jerash/mawzer/README.md

# mawzer
Mawzer modular MIDI controller
designed by Jerash Labs in 2006, Raphaël Mouneyres and WaveIdea

In 2024 we make some documents available to the public mainly for repairability.

Source code is made available without support or warranty
