jerash/mawzer/BOM/BOM Mawzer V0-2I.XLS

Sheet: Info
Mawzer modular MIDI controller designed by Jerash Labs in 2006, Raphaël Mouneyres and WaveIdea
In 2024 we make some documents available to the public mainly for repairability.
 | This is the main hierarchical BOM
 | ASS_* are assembly BOMs
 | PLAT_* are board BOMs

Sheet: ASS VALISE 16
N° | Description | Désignation | Footprint | Quantité | Commentaires | Fabricant | Référence
1 | ENCLOSURE MATRICE16 + SERIGRAPHY |  |  | 1 |  | KAP
2 | PLAT_Mainboard |  |  | 1 |  | KAP
3 | ASS_FDP |  |  | 8 |  | KAP
4 | LIMANDE_FDP |  |  | 1 |  | KAP
5 | SNAP BUSHING PLASTIC |  |  | 32 |  | KAP | MAWZER_SNAP_BUSHING
6 | CAP ENCODEUR S470006BLACK |  |  | 1 | JOG ENCODER | Sifam | S470006BLACK
7 | CAP ENCODEUR CF470CAP/HOLE BLACK |  |  | 1 | JOG ENCODER | Sifam | CF470CAP/HOLE BLACK
8 | CAP ENCODEUR DA210006BLACK |  |  | 1 | NAV ENCODER | Sifam | DA210006BLACK
9 | CAP ENCODEUR C210BLACK |  |  | 1 | NAV ENCODER | Sifam | C210BLACK
10 | CAP POWERSWITCH |  |  | 1 |  | KAP | switch button black
11 | SCREW M3.5X9,5 TC CRUSIF |  |  | 4 | Enclosure fixing to flightcase | SONY
12 | M3 screw |  | 5mm | 10 |  | KAP | Vis M3 fixation pcb sur tole
13 | FLIGHT CASE 32 MAWZER |  |  | 1 |  | Cipex | RRMAWZER32
14 | ALIM CUI DTS090133SUD |  |  | 1 |  | CUI | DTS090133SUD
15 | MAWZER EXTRACTION TOOL |  |  | 2 |  | KAP | MAWZER_EXTRACTION_TOOL
16 | USER MANUAL |  |  | 1 |  | SONY
17 | CE conformity sheet |  |  | 1 |  | SONY
19 | PACKAGING MAWZER16 |  |  | 1 |  | SONY
20 | Standard USB cable, 1.8m, A to B type |  |  | 1 |  | KAP

Sheet: ASS VALISE 32
N° | Description | Designation | Footprint | Quantité | Commentaires | Fabricant | Référence
1 | ENCLOSURE MATRICE32 + SERIGRAPHY |  |  | 1 |  | KAP
2 | PLAT_Mainboard |  |  | 1 |  | KAP
3 | ASS_FDP |  |  | 16 |  | KAP
4 | LIMANDE_FDP |  |  | 1 |  | KAP
5 | BRIDGE_FDP |  |  | 8 |  | KAP
6 | SNAP BUSHING PLASTIC |  |  | 64 |  | KAP | MAWZER_SNAP_BUSHING
7 | CAP ENCODEUR S470006BLACK |  |  | 1 | JOG ENCODER | Sifam | S470006BLACK
8 | CAP ENCODEUR CF470CAP/HOLE BLACK |  |  | 1 | JOG ENCODER | Sifam | CF470CAP/HOLE BLACK
9 | CAP ENCODEUR DA210006BLACK |  |  | 1 | NAV ENCODER | Sifam | DA210006BLACK
10 | CAP ENCODEUR C210BLACK |  |  | 1 | NAV ENCODER | Sifam | C210BLACK
11 | CAP POWERSWITCH |  |  | 1 |  | KAP | switch button black
12 | SCREW M3.5X9,5 TC CRUSIF |  |  | 4 | Enclosure fixing to flightcase | SONY
13 | M3 screw |  | 5mm | 10 |  | KAP | Vis M3 fixation pcb sur tole
14 | FLIGHT CASE 32 MAWZER |  |  | 1 |  | Cipex | RRMAWZER32
15 | ALIM CUI DTS090133SUD |  |  | 1 |  | CUI | DTS090133SUD
16 | MAWZER EXTRACTION TOOL |  |  | 2 |  | KAP | MAWZER_EXTRACTION_TOOL
17 | USER MANUAL |  |  | 1 |  | SONY
18 | CE conformity sheet |  |  | 1 |  | SONY
19 | PACKAGING MAWZER32 |  |  | 1 |  | SONY
20 | Standard USB cable, 1.8m, A to B type |  |  | 1 |  | KAP

Sheet: BRIDGE_FDP
N° | Description | Designation | Footprint | Quantité | Commentaires | Fabricant | Référence
1 | Header 3 pins |  |  | 2 |  | Molex | 51004-0300
2 | Terminals for Header 3 pins |  |  | 3 |  | Molex | 70058-0022
3 | AWG24 Wire |  |  |  |  | Any

Sheet: LIMANDE_FDP
N° | Description | Designation | Footprint | Quantité | Commentaires | Fabricant | Référence
1 | Header 24 pins double row |  |  | 1 |  | Molex | 70450-0011
2 | Terminals for Header 24 |  |  | 24 |  | Molex | 70058-0022
3 | Header 3 pins |  |  | 8 |  | Molex | 51004-0300
4 | AWG24 Wire |  |  |  |  | Any

Sheet: ASS POTh
N° | Description | Designation | Footprint | Quantité | Commentaires | Fabricant | Référence
1 | Enclosure POTh |  |  | 1 |  | KAP
2 | PLAT_Module_Core |  |  | 1 |  | KAP
3 | PLAT_POT |  |  | 1 |  | KAP
4 | Plastic Module 1U |  |  | 1 |  | KAP
5 | Jacks 6.35mm male with connector |  |  | 2 |  | TOPUP
6 | M3 screw |  | 5mm | 3 |  | KAP | M3 screw
7 | M3 screw |  | 20mm | 2 |  | KAP | M3 screw
8 | spacer for pcb |  | 11mm | 2 |  | KAP | round plastic/metal unthreaded
9 | Caps 3/02/DRN110 006/26 BLACK/PALE BLUE 105 |  |  | 4 |  | Sifam | 3/02/DRN110 006/26 BLACK/PALE BLUE 105

Sheet: ASS POTv
N° | Description | Designation | Footprint | Quantité | Commentaires | Fabricant | Référence
1 | Enclosure POTv |  |  | 1 |  | KAP
2 | PLAT_Module_Core |  |  | 1 |  | KAP
3 | PLAT_POT |  |  | 1 |  | KAP
4 | Plastic Module 1U |  |  | 1 |  | KAP
5 | Jacks 6.35mm male with connector |  |  | 2 |  | TOPUP
6 | M3 screw |  | 5mm | 3 |  | KAP | M3 screw
7 | M3 screw |  | 20mm | 2 |  | KAP | M3 screw
8 | spacer for pcb |  | 11mm | 2 |  | KAP | round plastic/metal unthreaded
9 | Caps 3/02/DRN110 006/26 BLACK/PALE BLUE 105 |  |  | 4 |  | Sifam | 3/02/DRN110 006/26 BLACK/PALE BLUE 105

Sheet: ASS FAD
N° | Description | Designation | Footprint | Quantité | Commentaires | Fabricant | Référence
1 | Enclosure FAD |  |  | 1 |  | KAP
2 | PLAT_Module_Core |  |  | 1 |  | KAP
3 | PLAT_FAD |  |  | 1 |  | KAP
4 | Plastic Module 1U |  |  | 1 |  | KAP
5 | Jacks 6.35mm male with connector |  |  | 2 |  | TOPUP
6 | M3 screw |  | 5mm | 3 |  | KAP | M3 screw
7 | M3 screw |  | 20mm | 2 |  | KAP | M3 screw
8 | spacer for pcb |  | 10mm | 2 |  | KAP | round plastic/metal unthreaded
9 | Cap 3/02/LK110 04 SLIDER BLACK WHITE LINE |  |  | 1 |  | Sifam | 3/02/LK110 04 SLIDER BLACK WHITE LINE

Sheet: ASS BUT
N° | Description | Designation | Footprint | Quantité | Commentaires | Fabricant | Référence fabricant
1 | Enclosure BUT |  |  | 1 |  | KAP
2 | PLAT_Module_Core |  |  | 1 |  | KAP
3 | PLAT_BUT |  |  | 1 |  | KAP
4 | Plastic Module 1U |  |  | 1 |  | KAP
5 | Jacks 6.35mm male with connector |  |  | 2 |  | TOPUP
6 | M3 screw |  | 5mm | 3 |  | KAP | M3 screw
7 | M3 screw |  | 20mm | 2 |  | KAP | M3 screw
8 | spacer for pcb |  | 14mm | 2 |  | KAP | round plastic/metal unthreaded

Sheet: ASS ENC
N° | Description | Designation | Footprint | Quantité | Commentaires | Fabricant | Référence fabricant
1 | Enclosure ENC |  |  | 1 |  | KAP
2 | PLAT_Module_Core |  |  | 1 |  | KAP
3 | PLAT_ENC |  |  | 1 |  | KAP
4 | Plastic Module 1U |  |  | 1 |  | KAP
5 | Jacks 6.35mm male with connector |  |  | 2 |  | TOPUP
6 | M3 screw |  | 5mm | 3 |  | KAP | M3 screw
7 | M3 screw |  | 20mm | 2 |  | KAP | M3 screw
8 | spacer for pcb |  | 13mm | 2 |  | KAP | round plastic/metal unthreaded
9 | Caps DCK 150 006 BLACK |  |  | 4 |  | Sifam | DCK 150 006 BLACK
10 | CapsTop C150 BLACK |  |  | 4 |  | Sifam | C150 BLACK

Sheet: ASS XFD
N° | Description | Designation | Footprint | Quantité | Commentaires | Fabricant | Référence
1 | Enclosure XFD |  |  | 1 |  | KAP
2 | PLAT_Module_Core |  |  | 1 |  | KAP
3 | PLAT_XFD |  |  | 1 |  | KAP
4 | Plastic Module 1U |  |  | 1 |  | KAP
5 | Jacks 6.35mm male with connector |  |  | 2 |  | TOPUP
6 | M3 screw |  | 5mm | 3 |  | KAP | M3 screw
7 | M3 screw |  | 20mm | 2 |  | KAP | M3 screw
8 | spacer for pcb |  | 8mm | 2 |  | KAP | round plastic/metal unthreaded
9 | Crossfader Knob |  |  | 1 |  | TOPUP | KB091

Sheet: PLAT_Motherboard
 | Description | Designator | Footprint | Quantity | Option | Manufacturer | Ref Manufacturer | Digikey PartNb | Mouser Partnb
1 | 1-of-8 FET Multiplexer/Demultiplexer | U18, U19 | D016 | 2 |  | Texas | SN74CBT3251D | 296-6428-5-ND
2 | 2-1 Analog Mux-Demux 3.3V | U6, U8 | SSOP8_DCT | 2 |  | Texas | SN74LVC2G53DCTR | 296-13269-1-ND
3 | 2-Input AND Gate | U7 | 419A-01 | 1 |  | Texas | SN74AHC1G08DCK | 296-8743-1-ND
4 | 3mm round Led - Red - Right angle SMD | D1 | LXH305SRD | 1 |  | Lumex | LXH305SRD |  | 696-SSF-LXH305SRD
5 | 5 pins 180 deg DIN connector female | J9 | SDS50J_DIN5_NB | 1 |  | CUI Inc | SDS-50J (MIDI IN 0) | CP-2350-ND
6 | 5 pins 180 deg DIN connector female | J8 | SDS50J_DIN5_NB | 1 |  | CUI Inc | SDS-50J (MIDI OUT 1) | CP-2350-ND
7 | 5 pins 180 deg DIN connector female | J7 | SDS50J_DIN5_NB | 1 |  | CUI Inc | SDS-50J (MIDI TRHU) | CP-2350-ND
8 | 8 pins socket, 2.54mm | J11 | DIP8_DUMMY | 1 | Cut 2 x 4 pins | KAP | mill-max 310-93-108-41-001000 | 929400E-01-08-ND
9 | 20 pins header, male 2.54mm single row | J1 | 20PIN_SINGLE_ROW | 1 |  | KAP | Amp 2-103239-0 | 929400E-01-20-ND
10 | 64K/4K Flash micro controller Z8encore | U9 | F-QFP10x10-G64/N | 1 |  | Zilog | Z8F6422AR020SG | 269-4283-ND
11 | Adjustable 500mA regulator | U16, U17 | D-PAK | 2 |  | on semiconductor | LM317MDT | LM317MDTRKGOSCT-ND
12 | Capacitor standard voltage 10% tolerance | C48 | 805 | 1 | ceramic | Any | 10nF
13 | Capacitor 10% tolerance | C27 | 1206 | 1 | ceramic | Any | 10uF/6.3V
14 | Capacitor standard voltage 10% tolerance | C57 | 805 | 1 | ceramic | Any | 1nF
15 | Capacitor 10% tolerance | C10 | 0805_NM | 1 | Not Mounted | Any | 1uF/6,3V
16 | Capacitor 10% tolerance | C54 | 805 | 1 | ceramic | Any | 2.2uF/6,3V
17 | Capacitor standard voltage 10% tolerance | C8, C39 | 0805_NM | 2 | Not Mounted | Any | 100nF
18 | Capacitor 10% tolerance | C35, C38 | 6032_ALU | 2 | electrolytic | Any | 10uF-25V
19 | Capacitor standard voltage 10% tolerance | C44, C45 | 805 | 2 | ceramic | Any | 12pf
20 | Capacitor standard voltage 10% tolerance | C25, C26 | 805 | 2 | ceramic | Any | 18pF
21 | Capacitor 10% tolerance | C40, C61 | 805 | 2 | ceramic | Any | 1uF/6,3V
22 | Capacitor 10% tolerance | C4, C23, C41 | CAP_ALU_4x5 | 3 | electrolytic | Any | 10uF/16V
23 | Capacitor 10% tolerance | C32, C34, C37 | 6032_ALU | 3 | electrolytic | Any | 47uF-25V
24 | Capacitor standard voltage 10% tolerance | C1, C2, C3, C5, C6, C7, C9, C11, C12, C13, C14, C15, C16, C17, C18, C19, C20, C21, C22, C24, C28, C29, C30, C31, C33, C36, C42, C43, C46, C47, C49, C50, C51, C52, C53, C58, C60 | 805 | 37 | ceramic | Any | 100nF
25 | connector header 2.5mm, 3x2 pins vertical | JP1 | HEADER_3X2 | 1 | NOT MOUNTED | KAP | HEADER 3X2 | 929710E-10-03-ND
26 | Crystal CMS | X1 | HC49/SUB | 1 |  | Citizen | HCM49-20.000MABJT (20MHz) | 300-6142-1-ND
27 | Crystal CMS | X2 | HC49/SUB | 1 |  | Citizen | HCM4924.000MABJTR |  | 695-HCM49-24
28 | Default Diode | D3, D5, D6, D7 | DSO-C2/X3.3 | 4 | DO-214AC | Any | 1N4001 | 1N4001-ND
29 | Diode bridge 1A - 50V, CMS | D4 | DF-S | 1 |  | Any | DF005S | DF005SDI-ND
30 | Diode small signal | D2 | 0805D | 1 | SOD-123 | Any | Diodes Inc 1N4148W-7 | 1N4148WDICT-ND | Boitier SOD-123
31 | Diode small signal | D8 | DSO-G2/Z5 | 1 | SOD-123 | Any | Diodes Inc 1N4148W-7 | 1N4148WDICT-ND | Boitier SOD-123
32 | DPDT switch, right angle pcb mounted | S21 | F2UEE | 1 |  | ITT Canon | F2UEE | 401-1223-ND
33 | Dual pins vertical, 2.54mm pitch | CON1 | 2_PINS_HEADER | 1 |  | KAP | STC02SYAN | S9000-ND
34 | Dual tri-state buffer | U5 | SSOP8_DCT | 1 |  | Texas | SN74LVC2G125DCTR | 296-12164-1-ND
35 | EZ-USB FX2 USB High-speed USB Peripheral Controller 16K | U4 | R-QFP14x20-G100/N | 1 |  | Cypress | CY7C68013A-100AXC | 428-1667-ND
36 | Ferrite bead - 1.5A | L1 | INDC4516-1806 | 1 |  | Murata | BLM41PG102SN1L | 490-1061-1-ND
37 | Hardware terminal with screw, right angle | J2, J4, J5 | KEYSTONE_EQUERRE | 3 |  | Keystone | 7690-3 | 7690K-ND
38 | Header, 12-Pin, Dual row, Right Angle | P2 | HDR2X12H | 1 |  | KAP | Header 12X2H
39 | Card Edgeboard Connectors .100 DIP 20POS | P5 | EBC10DCWN | 1 |  | Sullins | Sullins EBC10DCWN | S3299-ND
40 | Inductor choke type | L5 | 1210 | 1 |  | Murata | LQH3C100K04 | Obsolete | 81-LQH32CN100K01L
41 | Inductor high speed, low current | L2, L3 | 805 | 2 |  | Murata | BLM21B221SB
42 | Inductor high speed, USB power line | L4 | 805 | 1 |  | Murata | BLM21P221SG | 490-1054-2-ND | BLM21PG221SN1D
43 | LCD 128x64, STN blue negative, transmissive, white led bl | LCD1 | LCD_128X64_DUMMY | 1 |  | Microtips | MTG-S12864KMNHSGW-01 |  | voir Waveidea
44 | Optocoupler 8 pins DIP | U13 | DIP8 | 1 |  | Fairchild | 6N138 | 6N138QT-ND
45 | Piher Trimmer Potentiometers 10Kohms 10mm Rnd Top adj | P1 | PTV_POT | 1 |  | Piher | PT10V-10K |  | 531-PT10V-10K
46 | Power supply jack 2.1mm, right angle | J6 | JACK_ALIM_CUI | 1 |  | CUI Inc | PJ-102A | CP-102A-ND
47 | Power switch cap, round 8.8mm, gray | S22 | PWR_SW_CAP | 1 |  | ITT canon | FG/GRY | 401-1217-ND
48 | pushbutton + cap + led | SW4 | 3FTL6 | 1 |  | Mec | 3FTL6201Q091
49 | pushbutton + cap + led | SW1 | 3FTL6 | 1 |  | Mec | 3FTL6801R091
50 | pushbutton + cap + led | SW2, SW3, SW5, SW6, SW7, SW8, SW9, SW10 | 3FTL6 | 8 |  | Mec | 3FTL61P09
51 | Resetable fuse 1A - SMD | F1 | MF-SM050-2-99 | 1 |  | Bourns | MF-SM050-2-99 |  | 652-MFSM050-2-LF
52 | Rotary encoder, 25mm, no switch, no detent, D shaft | E2 | EC110102_EC16 | 1 |  | soundwell | EC110104B2B-HA1-022 (15P0-KA250A100-N)
53 | Rotary encoder, 16mm, with switch and detent, D shaft | E1 | EC110102_EC16 | 1 |  | soundwell | EC110101B2B-HA1-013 (15P6-FA200A100-N)
54 | Serial I2C EEPROM 16k x 8 DIP8 | U11 | DIP8 | 1 |  | Catalyst | CAT24AC128P
55 | Serial I2C EEPROM 32k x 8 DIP/SOIC8 | U1, U2, U3 | DIP8_SOIC8 | 3 |  | Atmel | AT24C256BN-10SU | AT24C256BN-10SU-1.8-ND
56 | shorting jumper 2.54 mm | J10 | JUMPER_DUMMY | 1 | open to disconect EZ-USB EEPROM | KAP
57 | Single buffer with 3 state output | U10 | SO-G5/P.95 | 1 | Not mounted | Texas | SN74AHCT1G125 | 296-4708-1-ND | SN74AHCT1G125DBVR (SOT23-5)
58 | Single buffer with 3 state output | U14, U15 | SO-G5/P.95 | 2 |  | Texas | SN74AHCT1G125 | 296-4708-1-ND | SN74AHCT1G125DBVR (SOT23-5)
59 | Standard CMS resistor 5% tolerance | R68 | 805 | 1 |  | Any | 1.2k
60 | Standard CMS resistor 5% tolerance | R91 | 805 | 1 |  | Any | 100R
61 | Standard CMS resistor 5% tolerance | R37 | 0805_NM | 1 | Not mounted | Any | 1M
62 | Standard CMS resistor 5% tolerance | R66 | 805 | 1 |  | Any | 470
63 | Standard CMS resistor 5% tolerance | R69 | 805 | 1 |  | Any | 5.6K
64 | Standard CMS resistor 5% tolerance | R77 | 805 | 1 |  | Any | 540R
65 | Standard CMS resistor 5% tolerance | R13, R19, R21, R36, R44, R50, R52, R55, R56, R57, R62, R64, R65 | 805 | 13 |  | Any | 0R
66 | Standard CMS resistor 5% tolerance | R54, R90 | 805 | 2 |  | Any | 100K
67 | Standard CMS resistor 5% tolerance | R16, R75 | 805 | 2 |  | Any | 1K
68 | Standard CMS resistor 5% tolerance | R4, R42 | 0805_NM | 2 | Not mounted | Any | 1K
69 | Standard CMS resistor 5% tolerance | R1, R2, R88, R89 | 805 | 4 |  | Any | 2.2k
70 | Standard CMS resistor 5% tolerance | R10, R12, R74, R76 | 805 | 4 |  | Any | 330R
71 | Standard CMS resistor 5% tolerance | R3, R5, R6, R7, R8, R9, R11, R14, R15, R17, R20, R23, R24, R25, R26, R27, R28, R29, R30, R31, R32, R33, R34, R35, R38, R39, R40, R43, R45, R63, R78, R79, R80, R81, R82, R83, R84, R85, R87, R92, R93, R94 | 805 | 42 |  | Any | 10K
72 | Standard CMS resistor 5% tolerance | R18, R22, R41, R47, R49, R51 | 0805_NM | 6 | Not mounted | Any | 0R
73 | Standard CMS resistor 5% tolerance | R53, R67, R70, R71, R72, R73 | 805 | 6 |  | Any | 220
74 | Standard CMS resistor 5% tolerance | R46, R48, R58, R59, R60, R61, R86, R95 | 0805_NM | 8 | Not mounted | Any | 10K
75 | USB Connector type B pcb mounted, 4 pins | J3 | USBCON | 1 |  | Kobicon | 154-2442 |  | 154-2442-E
76 | USB transient suppressor | U12 | DBV6 | 1 |  | Texas Inst | SN65220DBVT | 296-2341-2-ND
77 | PCB_Mainboard |  |  | 1 |  | KAP | PCB_Mainboard

Sheet: PLAT_CommonModule
 | Description | Designator | Footprint | Quantity | Option | Manufacturer | Ref | Digikey PartNb | Mouser PartNb
1 | Capacitor | C1000, C1004, C1006, C1007, C1009, C1010, C1012, C1013 | 805 | 8 | ceramic | Any | 100nF |  | 80-C0805C104K5R
2 | Capacitor | C1001, C1002 | 805 | 2 | ceramic | Any | 18pF |  | 80-C0805C180K5G
3 | Capacitor | C1003 | TC3528-1411 | 1 | electrolytic | Kemet | 47uF/10V | 493-2094-1-ND | 647-UWX1A470MCL1
4 | Capacitor | C1005, C1011 | 805 | 2 | ceramic | Any | 1uF |  | 581-0805ZC105K
5 | Capacitor | C1008 | CAP_ALU_4x5 | 1 | electrolytic | Kemet | 10uF/16V | 493-2099-6-ND | 647-UWX1C100MCL2
6 | connector header 2.5mm, 3x2 pins vertical | JP1000 | HEADER_3X2 | 1 | 2.54mm | KAP | HEADER 3X2 |  | 538-10-89-7061
7 | Inductor 0,1µH | L1000, L1001, L1002 | 805 | 3 |  | Any | CK2125R10M | 587-1685-1-ND
8 | Header, 3-Pin | P1000, P1001 | 530150310 | 2 | 2.54mm | KAP | molex 530150310 |  | 538-53015-0310
9 | Header, 20-Pin | P1002 | HDR1X20 | 1 | 2.54mm | KAP | TSW-120-17-G-S | 929400E-01-20-ND
10 | Standard CMS resistor | R2, R1016 | 805 | 2 | 5 % | Any | 2.2k |  | 71-CRCW0805J-2.2K
11 | Standard CMS resistor | R1000, R1002, R1012 | 805 | 3 | 5 % | Any | 10K |  | 71-CRCW0805J-10K-E3
12 | Standard CMS resistor | R1001 | 805 | 1 | 5 % | Any | 220R |  | 71-CRCW0805J-220
13 | Standard CMS resistor | R1003, R1005 | 0805_NM | 2 | Not mounted | Any | 10K | * | *
14 | Standard CMS resistor | R1004, R1008, R1010, R1014, R1017 | 805 | 5 | 5 % | Any | 0R |  | 71-CRCW0805-0-E3
15 | Standard CMS resistor | R1006 | 0805_NM | 1 | Not mounted | Any | 100K | * | *
16 | Standard CMS resistor | R1007, R1009, R1013 | 0805_NM | 3 | Not mounted | Any | 0R | * | *
17 | Standard CMS resistor | R1011 | 805 | 1 | 5 % | Any | 1K |  | 71-CRCW0805J-1K-E3
18 | Standard CMS resistor | R1015 | 0805_NM | 1 | Not mounted | Any | 45K | * | *
19 | DIP Switch, 6 Position, SPST | S1000 | BPA06SB | 1 |  | ITT | BPA06SB | CKN6145-ND | 611-BPA06SB
20 | Single buffer with 3 state output | U1000 | SO-G5/P.95 | 1 | PACKAGE ? | Texas | SN74AHCT1G125 | 296-4708-1-ND
21 | 200mA LDO - 5pins - 3.3V fixed output | U1001 | SO-G5/P.95 | 1 | PACKAGE ? | Texas | TPS79333 | 296-12961-1-ND
22 | Analog mux | U1002 | SOIC16D | 1 |  | Philips | CD74HC4051M | 296-14530-1-ND | 595-CD74HC4051M96
23 | 4K/1K Flash micro controller Z8encore - SOIC28 | U1003 | SOIC28 | 1 |  | Zilog | Z8F0422SJ020SG | 269-4143-ND | 692-Z8F0422SJ020SG
24 | Serial I2C EEPROM 2k x 8 SOIC8 | U1004 | SO-G8 | 1 |  | Atmel | AT24C16A-10SU-2.7 | AT24C16AN-10SU2.7-ND
25 | Crystal CMS | X1000 | HC49/SUB | 1 | NO ROHS NOSTOCK | Citizen | HCM49-20.000MABJT (20MHz) | 300-6142-2-ND | 695-HCM49-20
26 | M3 screw | - | - | 2 | - | KAP | Vis M3 pour fixation pcb sur spacers | * | *
27 | PCB CommonModule | - | - | 1 | - | KAP | PCB_COMMONMODULE | * | *

Sheet: PLAT_FDP
N° | Description | Designation | Footprint | Quantité | Commentaires | Fabricant | Référence
1 | PCB FDP |  |  | 1 |  | KAP
2 | Jack Socket, 6 pins right angle | J1,J2,J3,J4 | NMJ6HCD2 | 4 |  | Neutrik | NMJ6HCD2
3 | Header 3 pins right angle | P1, P2 | 530150310 | 1 |  | Molex | 530150310

Sheet: PLAT_POT
 | Description | Designator | Footprint | Quantity | Option | Manufacturer | Ref Manufacurer
1 | PCB POT |  |  | 1 |  | KAP
2 | Rotary potentiometer 11mm type vertical | P1, P2, P3, P4 | RA1150NOE0D-HA1 | 4 |  | Soundwell | RA1150NOE0D-HA1-064(B103-Q0--FB175B120-N)
3 | Header, 20-Pin, 2.54mm pitch | P1002 | HDR1X20 | 1 |  | Any

Sheet: PLAT_FAD
 | Description | Designator | Footprint | Quantity | Option | Manufacturer | Ref Manufacturer
1 | PCB FAD |  |  | 1 |  | KAP
2 | fader potentiometer 100mm type vertical | P1 | SKA191NOA0A-HA1 | 1 |  | Soundwell | SKA191NOA0A-HA1-B103-Q0-M13A100
3 | Header, 20-Pin, 2.54mm pitch | P1002 | HDR1X20 | 1 |  | Any

Sheet: PLAT_BUT
 | Description | Designator | Footprint | Quantity | Option | Manufacturer | Ref Manufacturer
1 | PCB BUT |  |  | 1 |  | KAP
2 | Boutons poussoir | SW1, SW2, SW3, SW4 | TL1240 | 4 |  | E-switch | TL1240RQ/2J-BLK
3 | Standard CMS resistor 10K | R1, R3, R5, R7 | 0805 | 4 |  | Any | Standard CMS resistor 10K
4 | Standard CMS resistor 330R | R2, R4, R6, R8 | 0805 | 4 |  | Any | Standard CMS resistor 330R
5 | Header, 20-Pin, 2.54mm pitch | P1002 | HDR1X20 | 1 |  | Any

Sheet: PLAT_ENC
 | Description | Designator | Footprint | Quantity | Option | Manufacturer | Ref Manufacturer
1 | PCB_ENC |  |  | 1 |  | KAP
2 | Encoders 15pulse/rotation w/detent | E1, E2, E3, E4 |  | 4 |  | Soundwell | EC110104B2B-HA1-020(15P6-FA200A100-N)
3 | Standard CMS capacitor 100nF | C1, C2, C3, C4, C5, C6, C7,C8, C9 | 0805 | 9 |  | Any | Standard CMS capacitor 100nF
4 | Standard CMS resistor 10K | R1, R2, R3, R4, R5, R6, R7,R8, R9, R10, R11, R12, R13,R14, R15, R16 | 0805 | 16 |  | Any | Standard CMS resistor 10K
5 | Header, 20-Pin, 2.54mm pitch | P1002 | HDR1X20 | 1 |  | Any
6 | Dual tri-state buffer | U5 | SSOP8_DCT | 1 |  | Texas Instruments | SN74LVC2G125DCTR

Sheet: PLAT_XFD
 | Description | Designator | Footprint | Quantity | Option | Manufacturer | Ref Manufacturer
1 | PCB_XFD |  |  | 1 |  | KAP
2 | slider potentiometer 60mm type vertical | P1 | SC6005NOA0X-HA1 | 1 |  | Soundwell | SC6005NOA0X-HA1-1B103-Q0-M13A150
3 | Buttons | SW1, SW2 |  | 2 |  | MEC | 3FTL680
4 | Buttons Caps |  |  | 2 |  | MEC | 1Q091
5 | Standard CMS resistor 10K | R1, R2 | 0805 | 2 |  | Any | Standard CMS resistor 10K
6 | Standard CMS resistor 330R | R3, R4 | 0805 | 2 |  | Any | Standard CMS resistor 330R
7 | Header, 20-Pin, 2.54mm pitch | P1002 | HDR1X20 | 1 |  | Any
