jerash/mawzer/(list of files, cad)

Other CAD files:
src/Motherboard/EzUsb_FX1_Fw_v10/main.OBJ
src/Motherboard/EzUsb_FX1_Fw_v10/dscr_bs3x.OBJ
src/Motherboard/EzUsb_FX1_Fw_v10/identity_inc.obj
src/Motherboard/EzUsb_FX1_Fw_v10/usb.OBJ
src/Motherboard/EzUsb_FX1_Fw_v10/STARTUP.OBJ
src/Motherboard/EzUsb_FX1_Fw_v10/serial.OBJ
src/Motherboard/EzUsb_FX1_Fw_v10/hardware.OBJ
src/Motherboard/EzUsb_FX1_Fw_v10/fw.OBJ
src/Motherboard/EzUsb_FX1_Fw_v10/periph.OBJ
src/Motherboard/EzUsb_FX1_Fw_v10/bootloader.OBJ
src/Motherboard/EzUsb_FX1_Fw_v10/midi_dscr.OBJ
src/Motherboard/EzUsb_FX1_Fw_v10/USBJmpTb.OBJ
src/Motherboard/EzUsb_FX1_Fw_v10/itr.OBJ
src/Motherboard/EzUsb_FX1_Fw_v10/dscr_mawzer.OBJ
src/Motherboard/EzUsb_FX1_Fw_v10/dscr.OBJ
src/Motherboard/EzUsb_FX1_Fw_v10/identity.OBJ
