jerash/mawzer/schematics/BUT_MODULE_V10.pdf

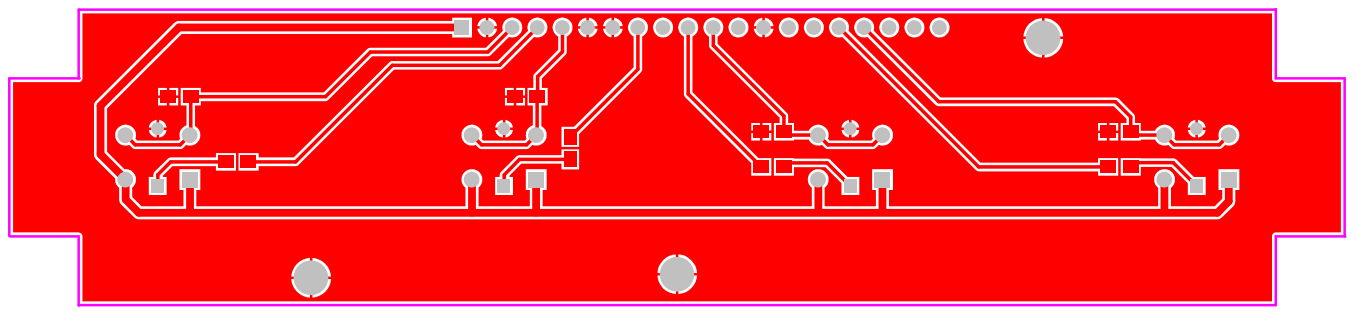
[picture p1: page 1]

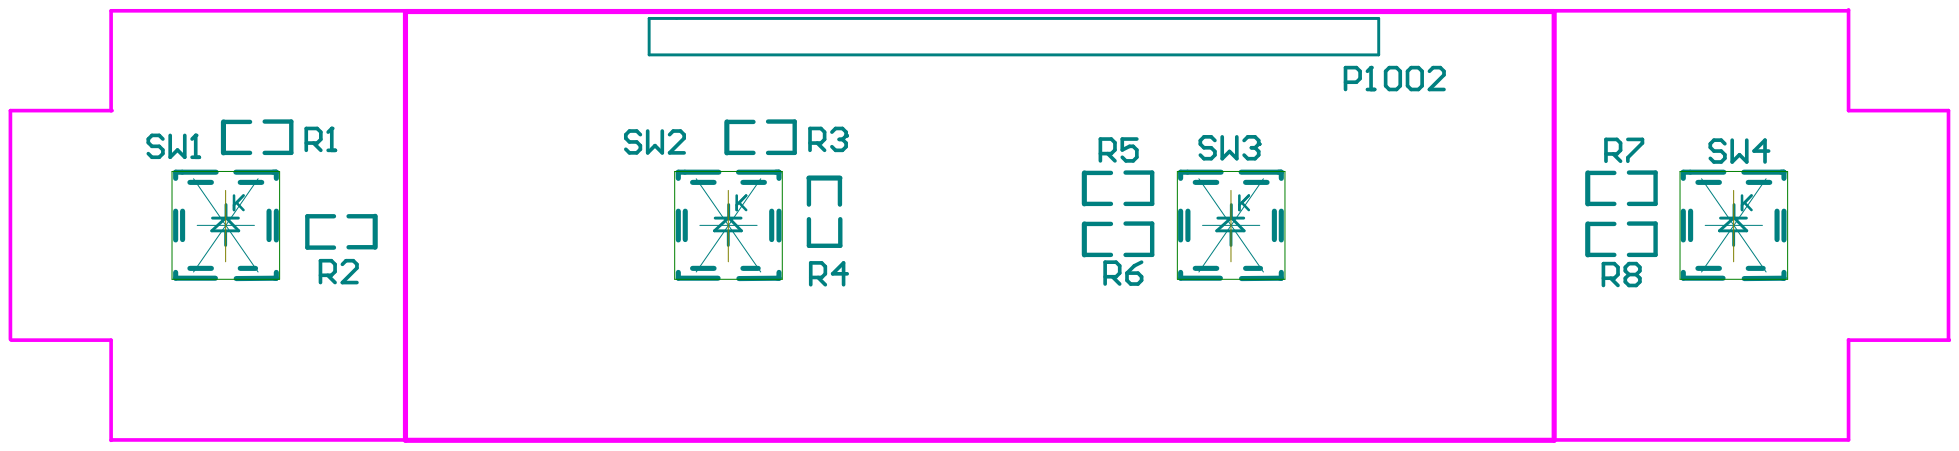
[picture p2: page 2]

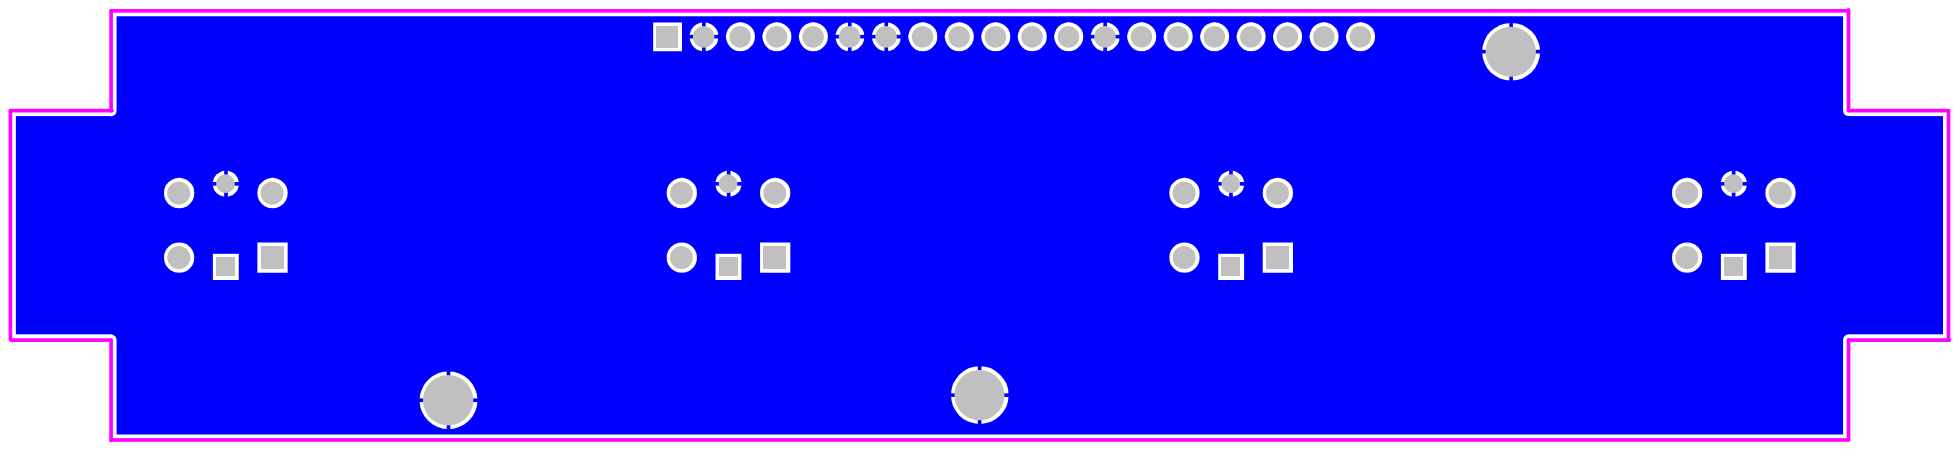
[picture p3: page 3]

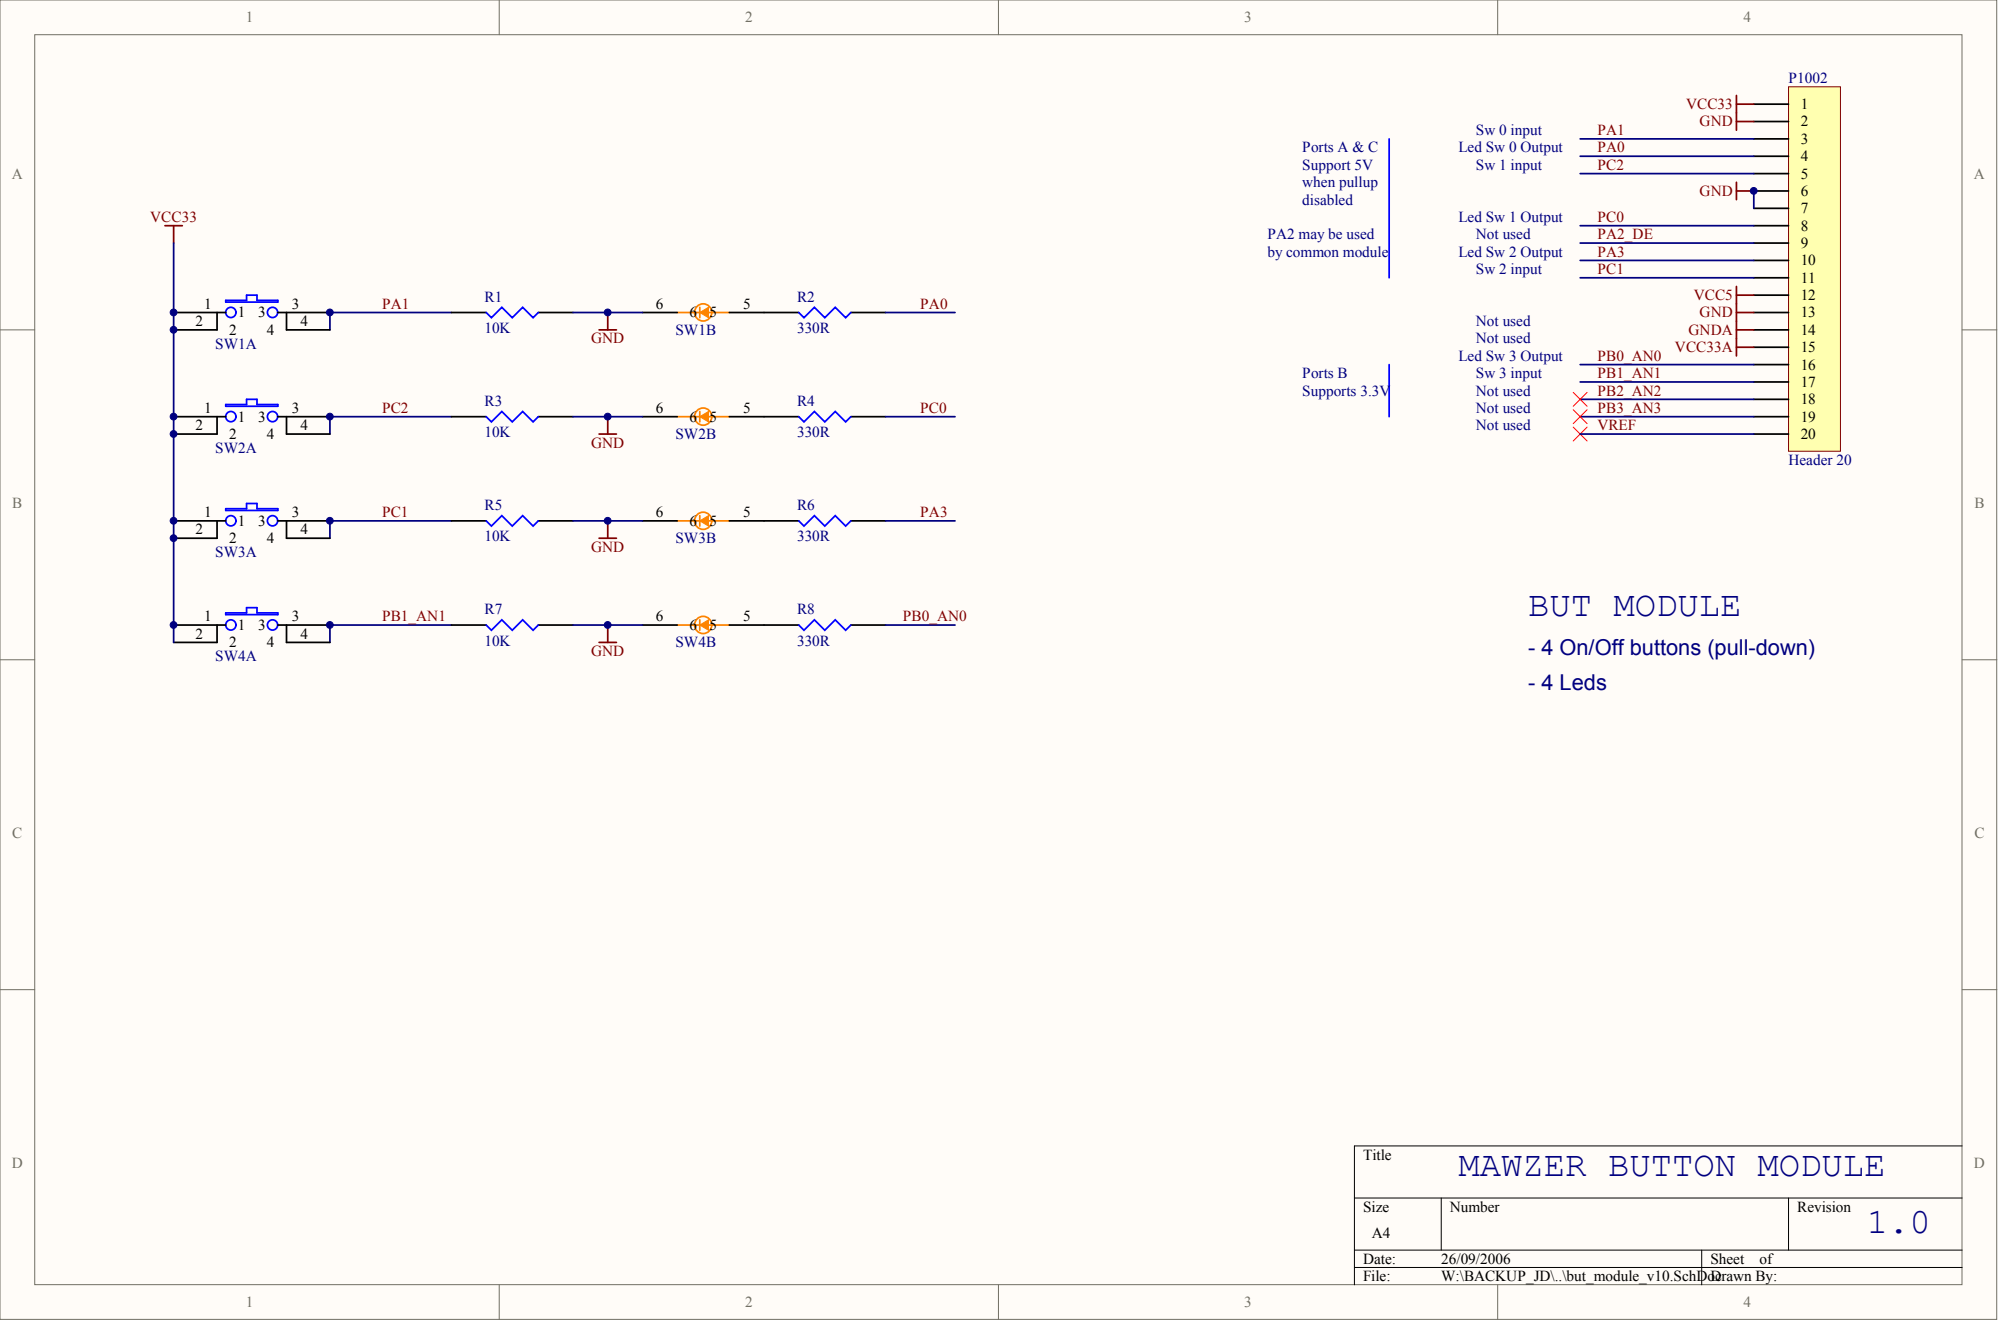
[picture p4: page 4]

Led Sw 0 Output Led Sw 1 Output Led Sw 2 Output Led Sw 3 Output
Sw 1 input

- 4 On/Off buttons (pull-down)
- 4 Leds
