jerash/mawzer/schematics/common_module_v10.pdf

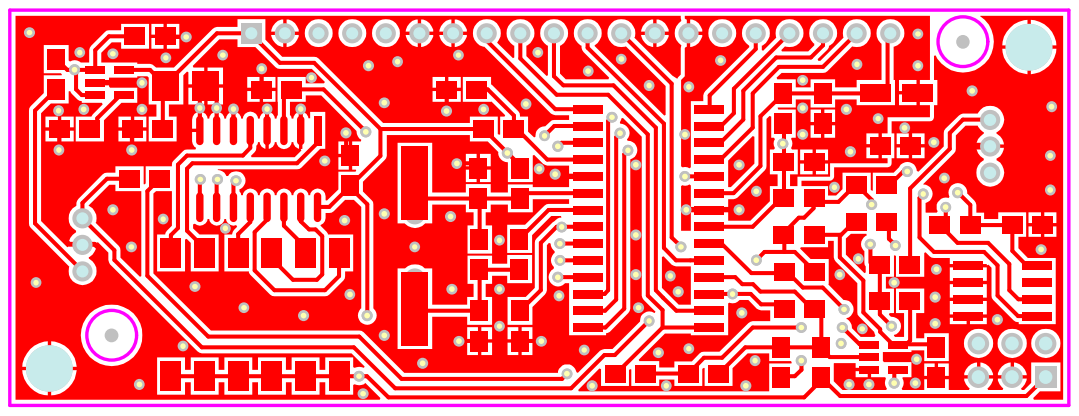
[picture p5: page 1]

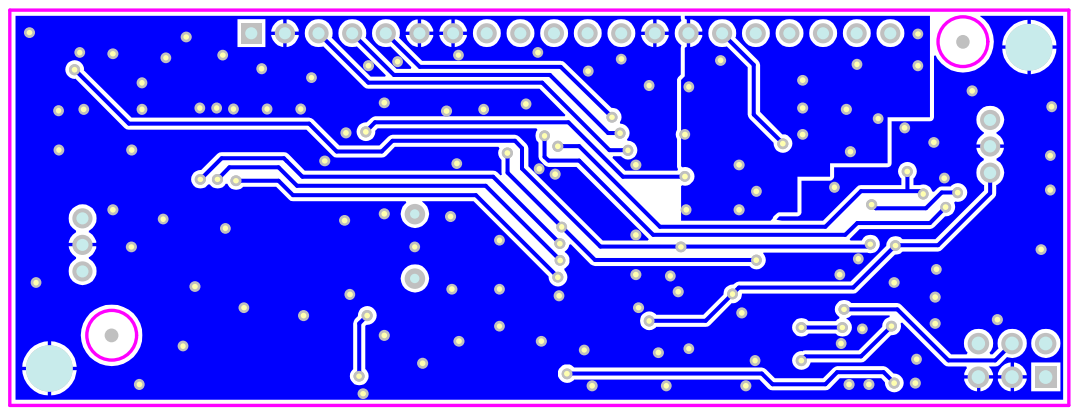
[picture p6: page 2]

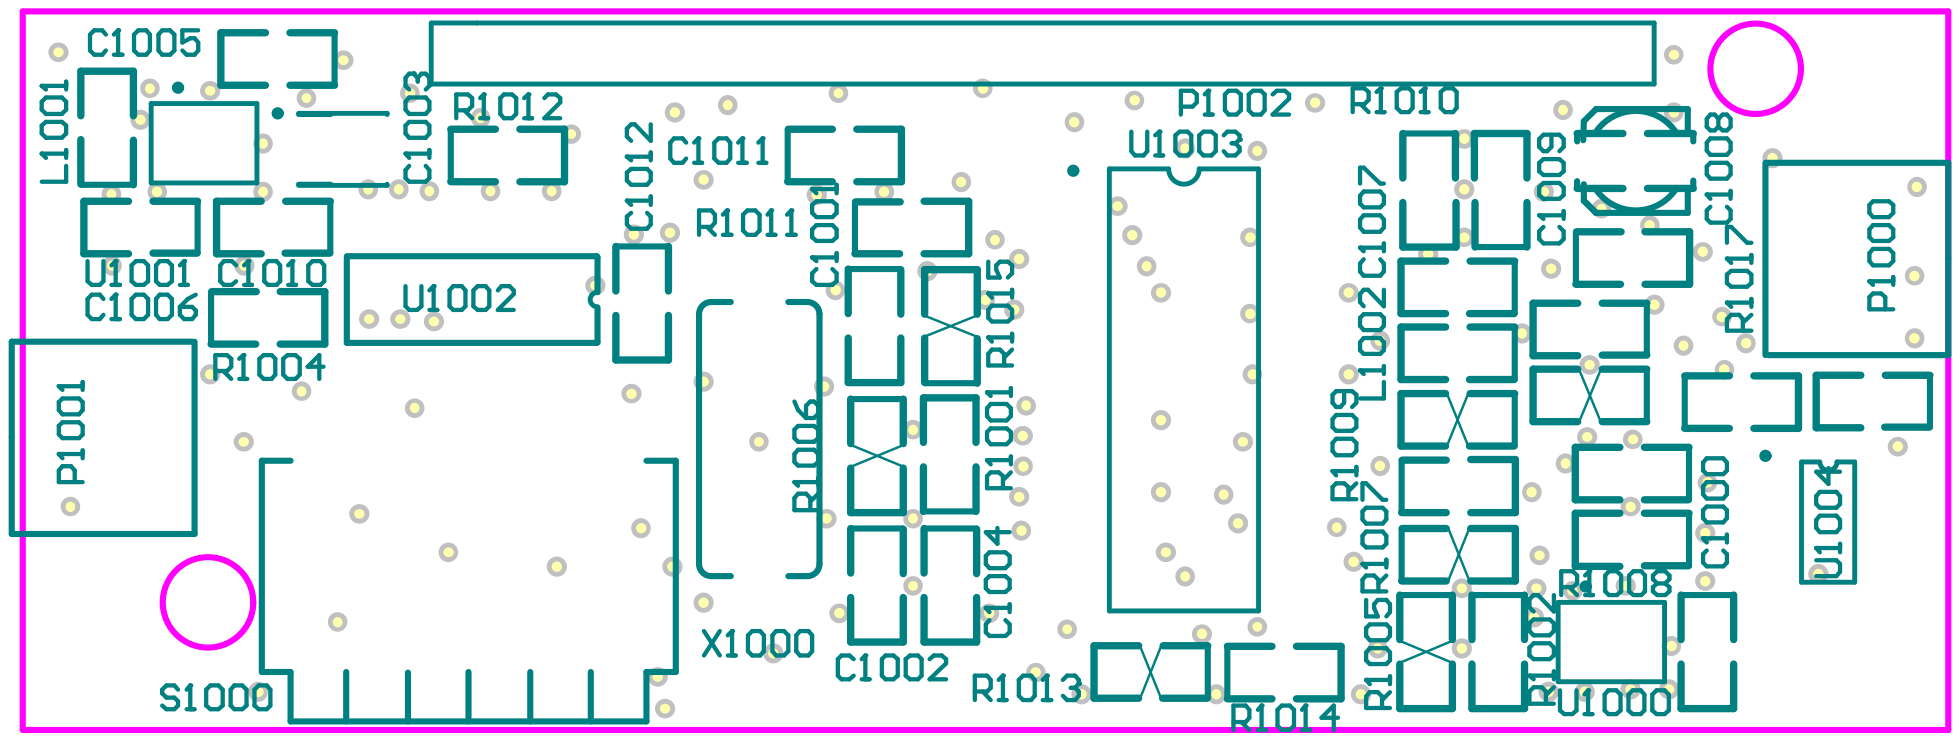
[picture p7: page 3]

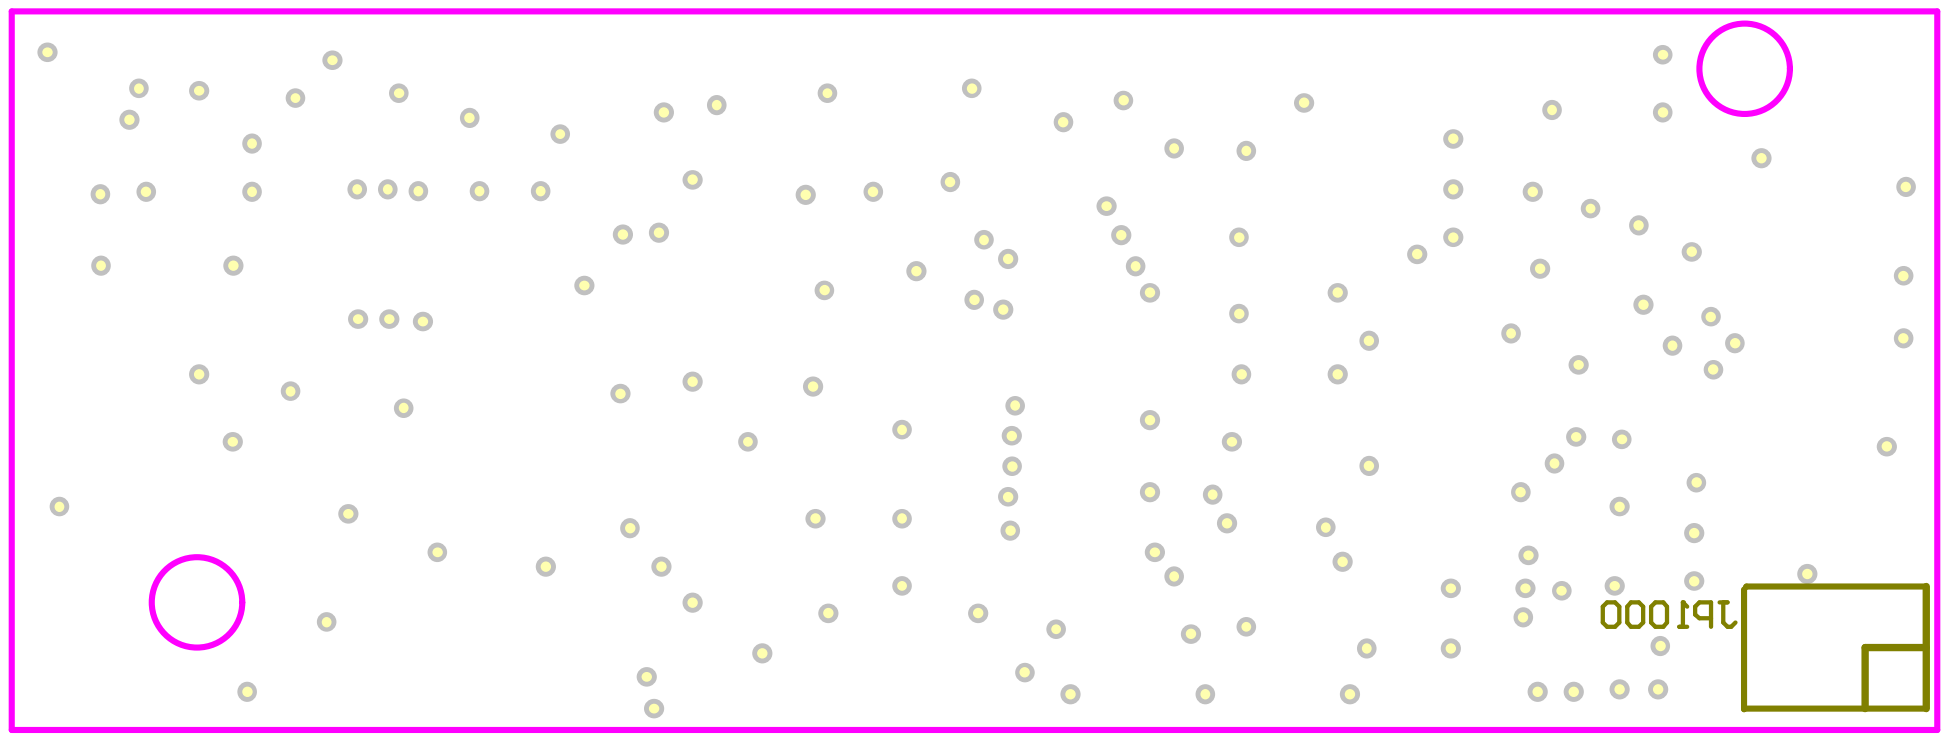
[picture p8: page 4]

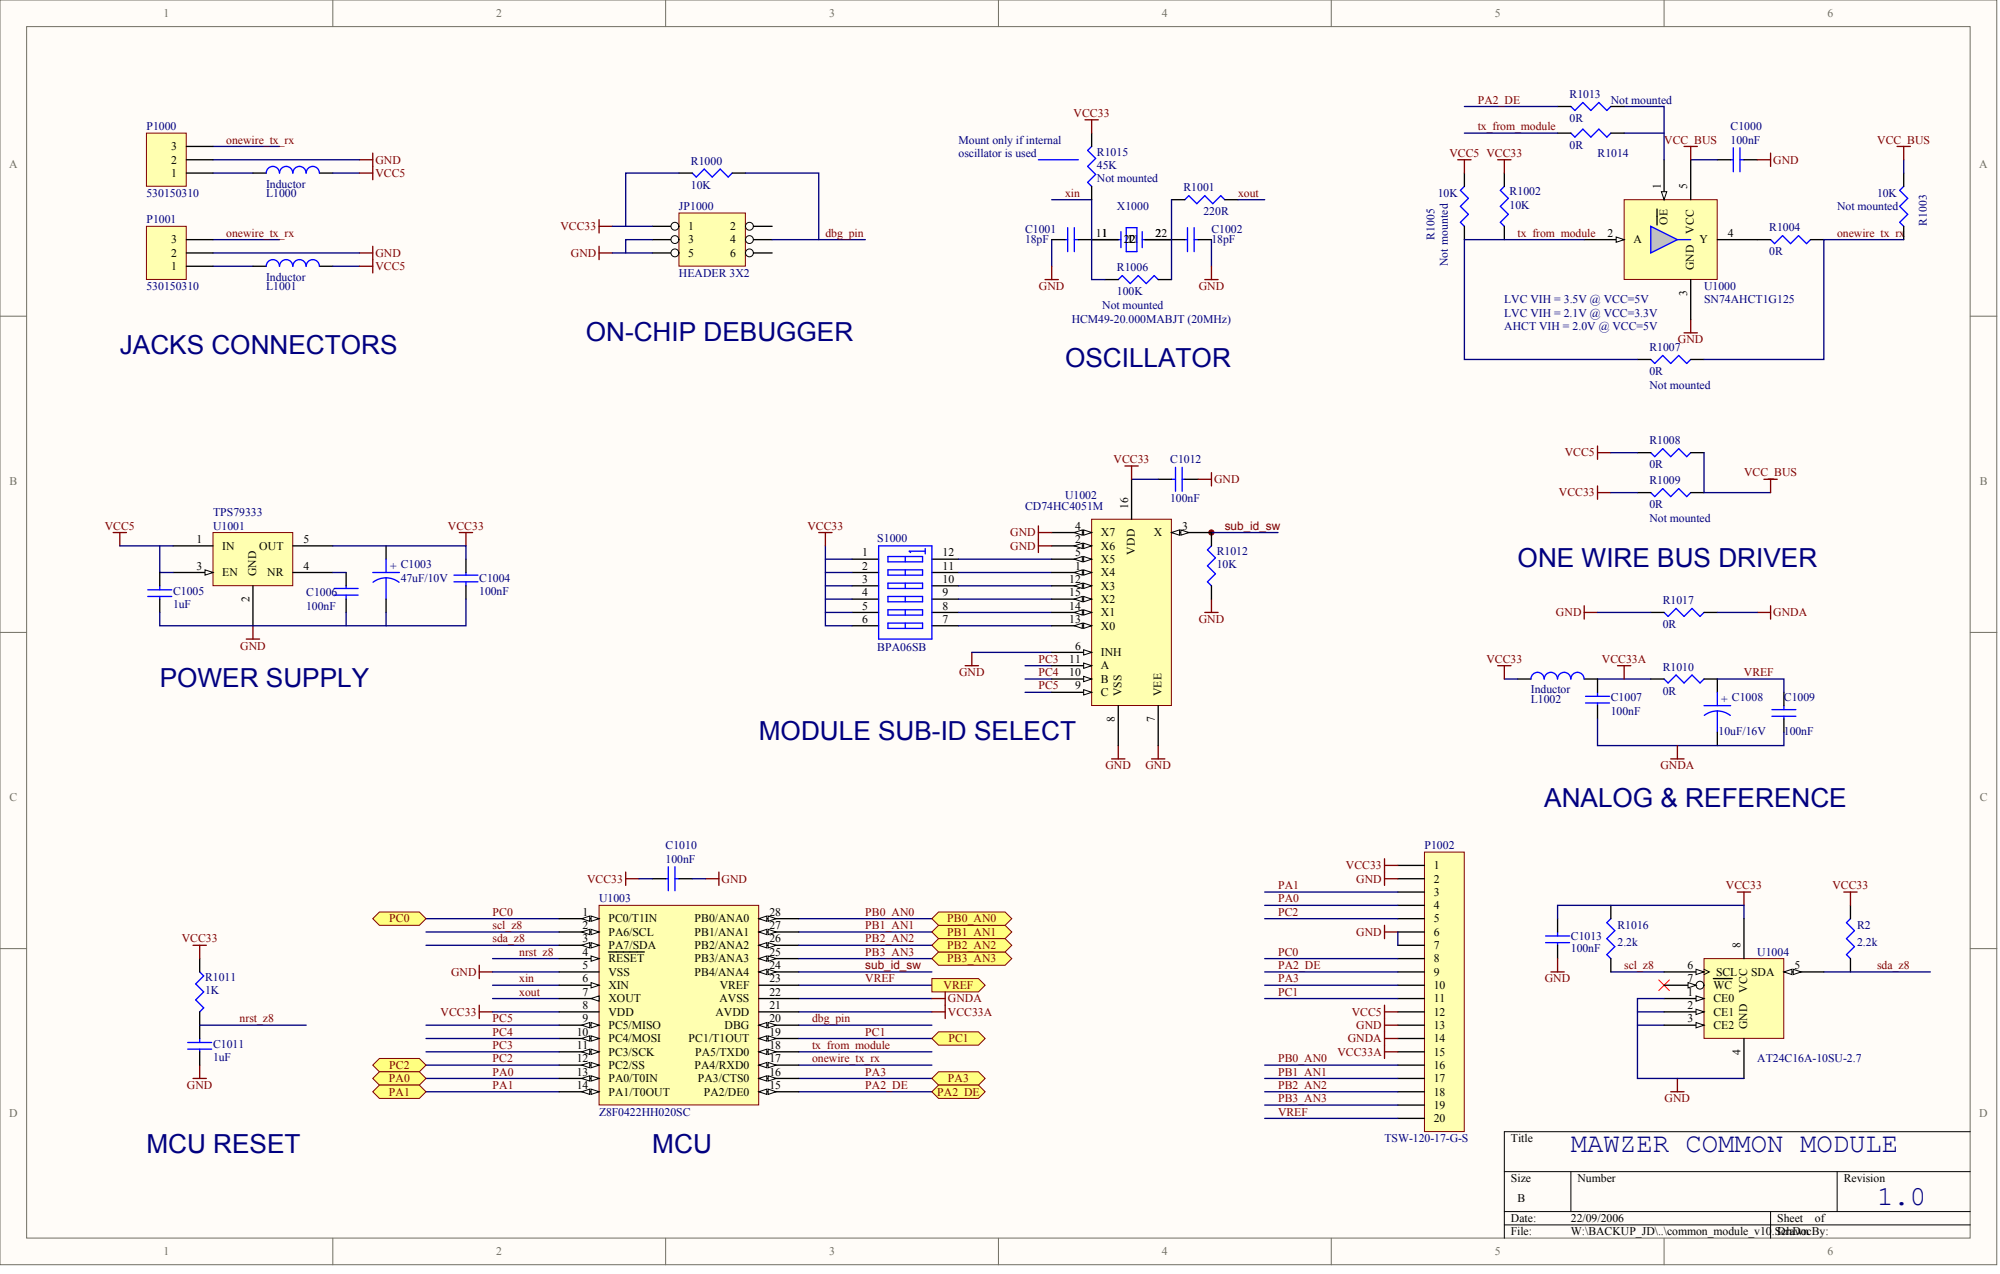
[picture p9: page 5]

Mount only if internal
oscillator is used

ONE WIRE BUS DRIVER

2 P0S100002 P0S100002 P0S100002 | P0S1000011 P0S1000011 P0S1000011 11 P0U100201 P0U100201 P0U100201
3 P0S100003 P0S100003 P0S100003 | P0S1000010 P0S1000010 P0S1000010 10 P0U1002012 P0U1002012 P0U1002012
4 P0S100004 P0S100004 P0S100004 | P0S100009 P0S100009 P0S100009 9 P0U1002015 P0U1002015 P0U1002015
5 P0S100005 P0S100005 P0S100005 | 8 P0S100008 P0S100008 P0S100008 P0U1002014 P0U1002014 P0U1002014
P0S100006 6 P0S100006 P0S100006 | P0S100007 P0S100007 P0S100007 7 P0U1002013 P0U1002013 P0U1002013

MODULE SUB-ID SELECT
