jerash/mawzer/schematics/FAD_MODULE_V12.pdf

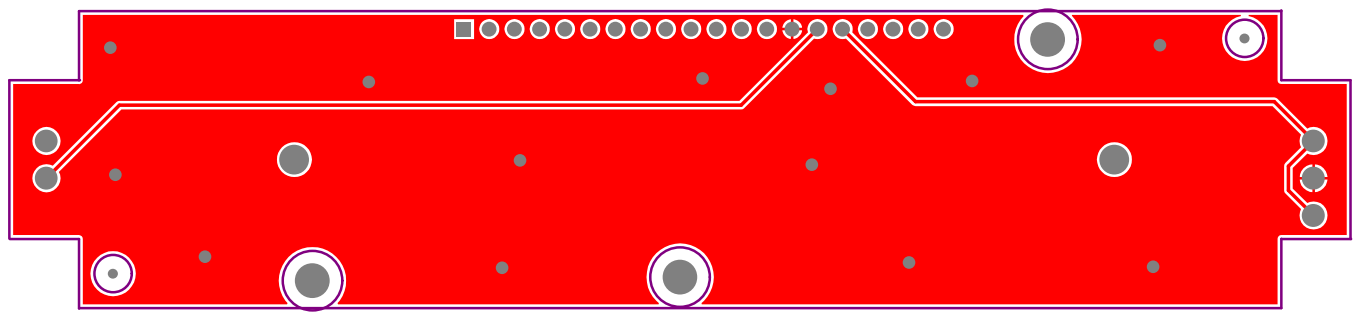
[picture p10: page 1]

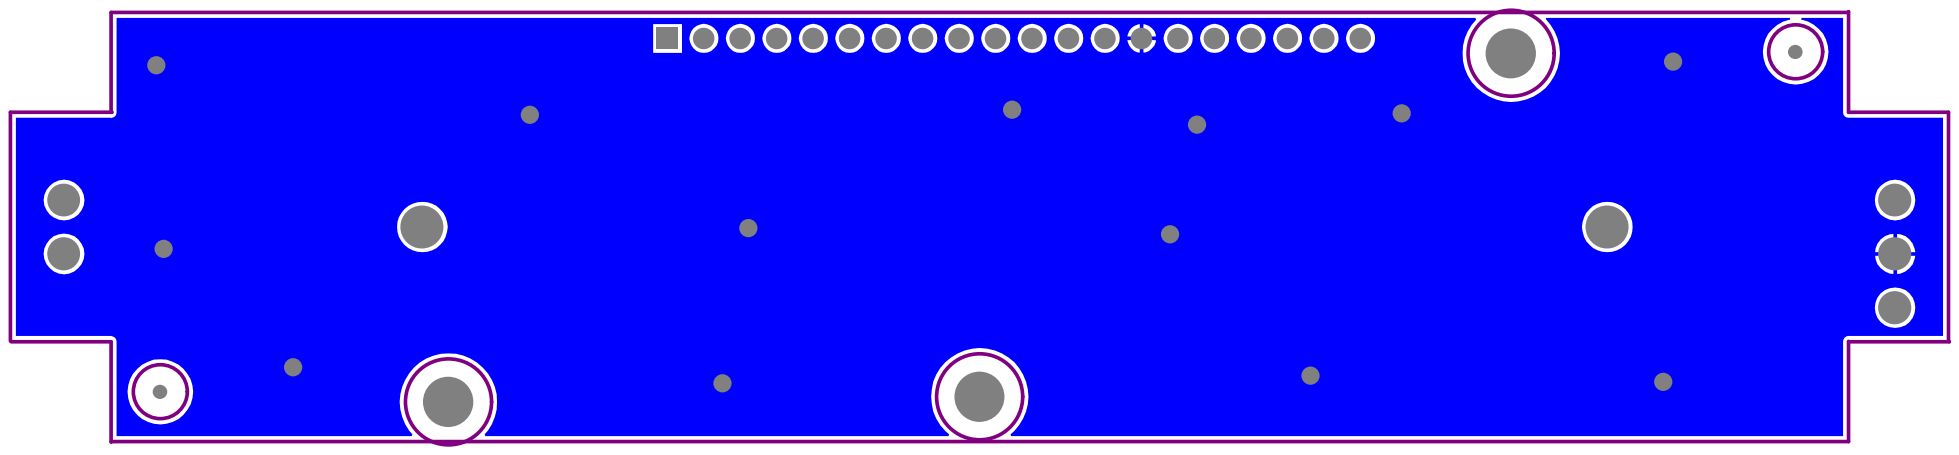
[picture p11: page 2]

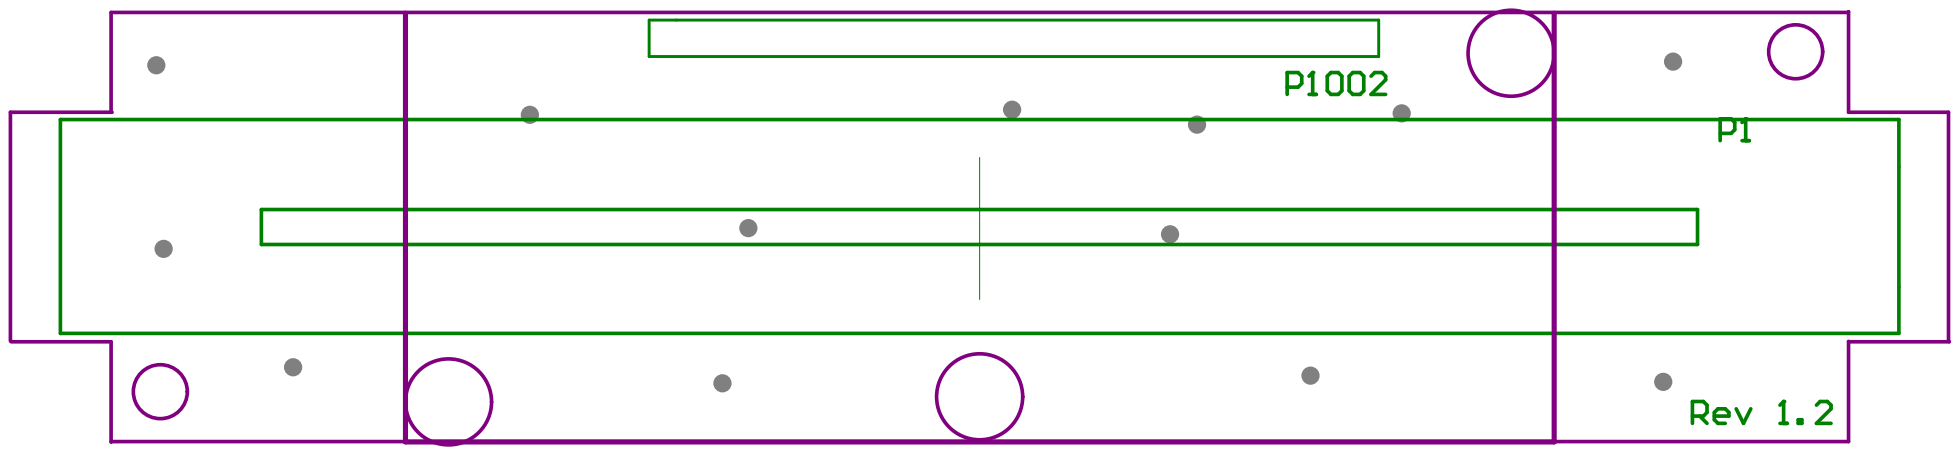
[picture p12: page 3]

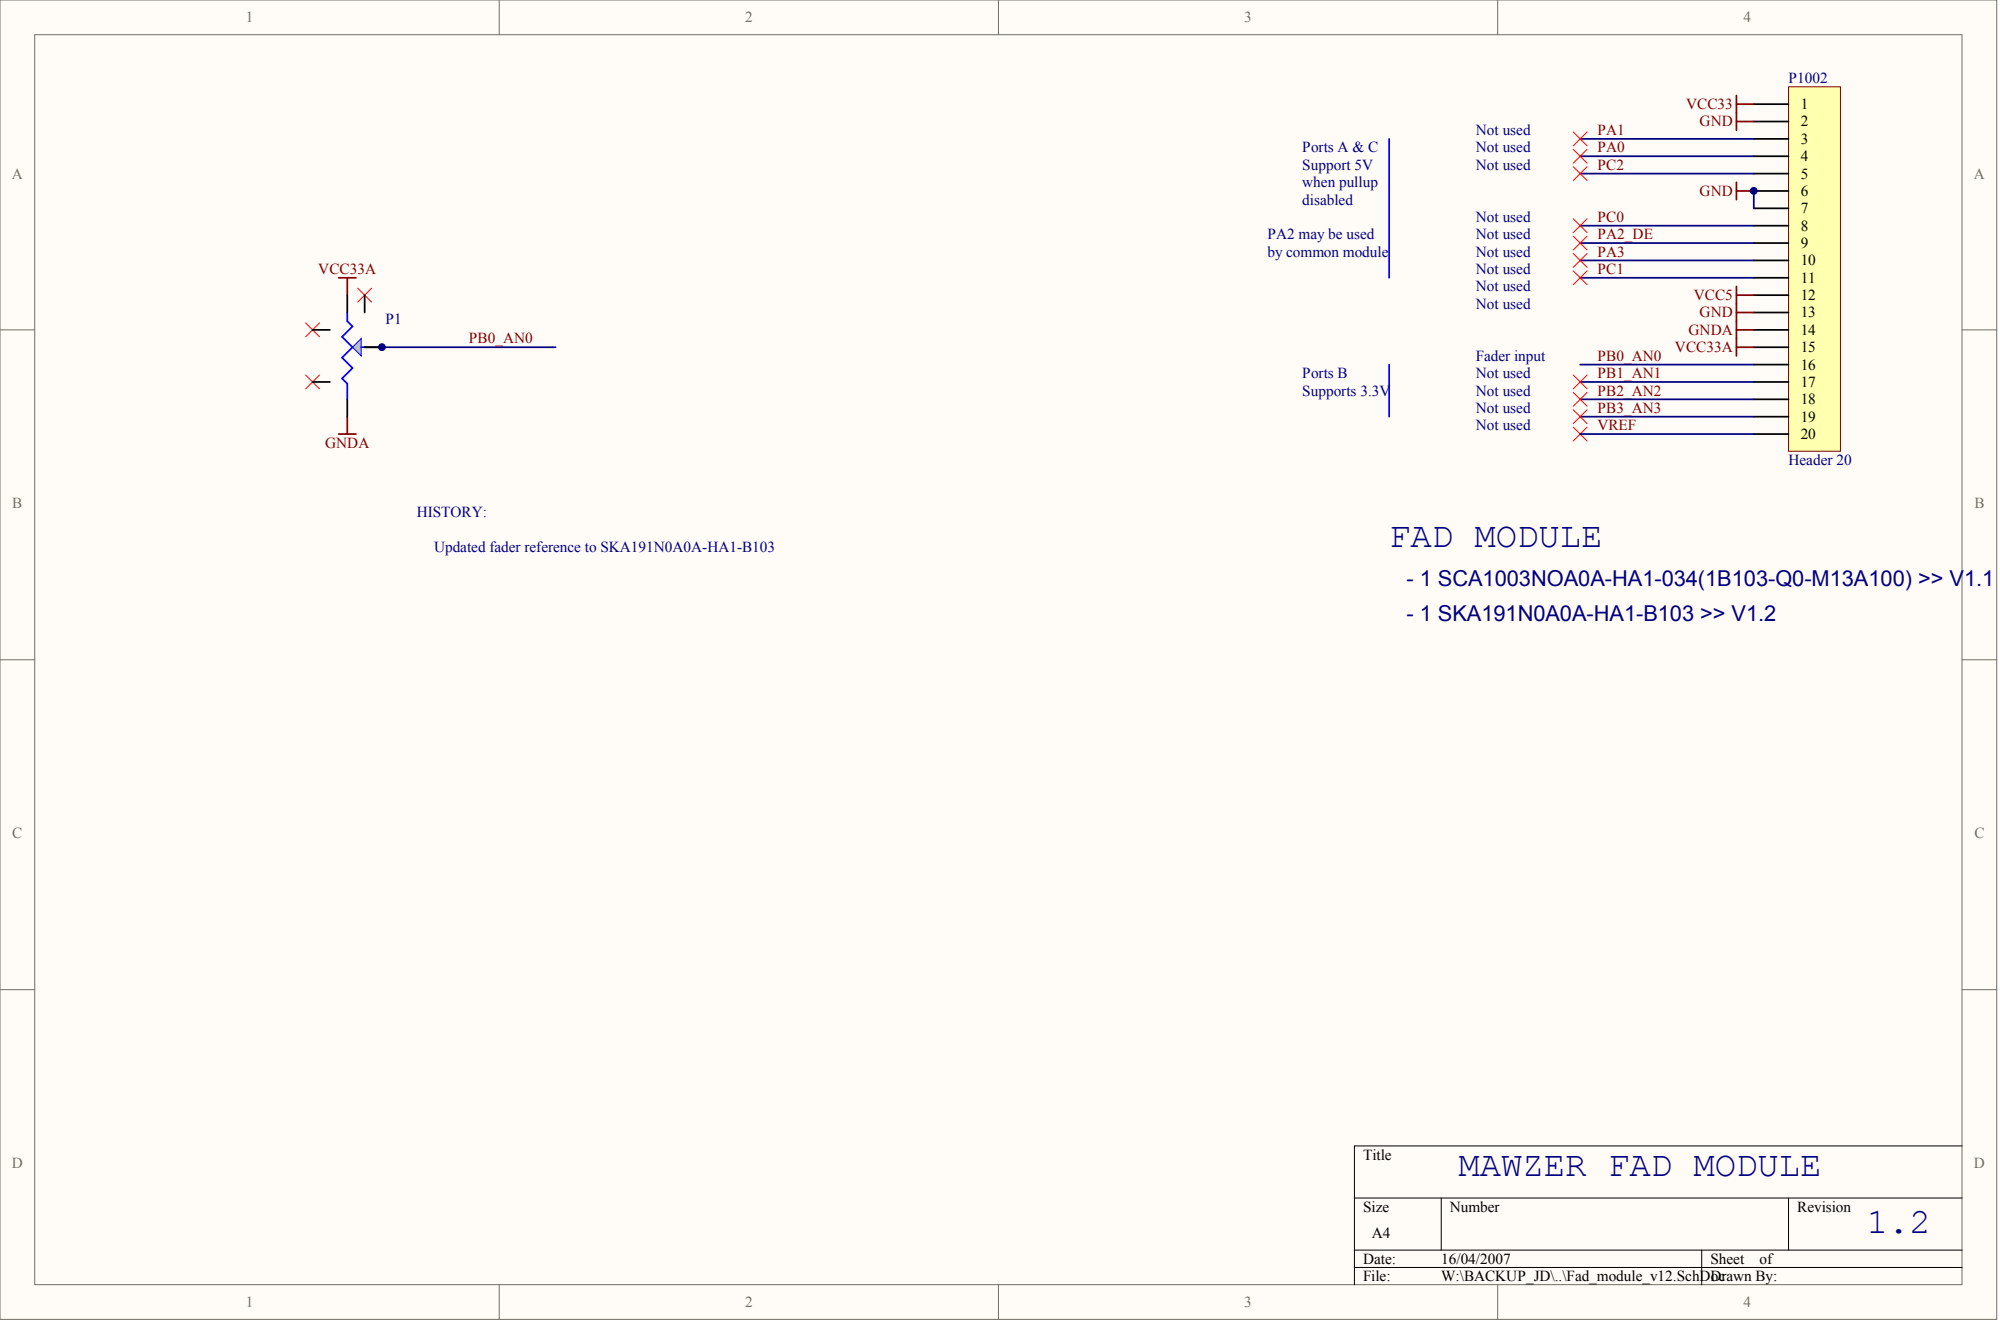
[picture p13: page 4]
Date:; Sheet of File:; W:\BACKUP_JD\..\Fad_module_v12.SchDocDrawn By; Not used; FAD MODULE; - 1 SCA1003NOA0A-HA1-034(1B103-Q0-M13A100) >> V1.1; Support 5V Ports A & C; when pullup; Supports 3.3V Ports B; PA2 may be used; by com; mon module; Header 20; VREF PB3_AN3 PB2_AN2 PC1; Not used Not used Not used Not used; - 1 SKA191N0A0A-HA1-B103 >> V1.2

Not used Fader input

Updated fader reference to SKA191N0A0A-HA1-B103

MAWZER FAD MODULE
