jerash/mawzer/schematics/JACKS_MATRIX_V10.pdf

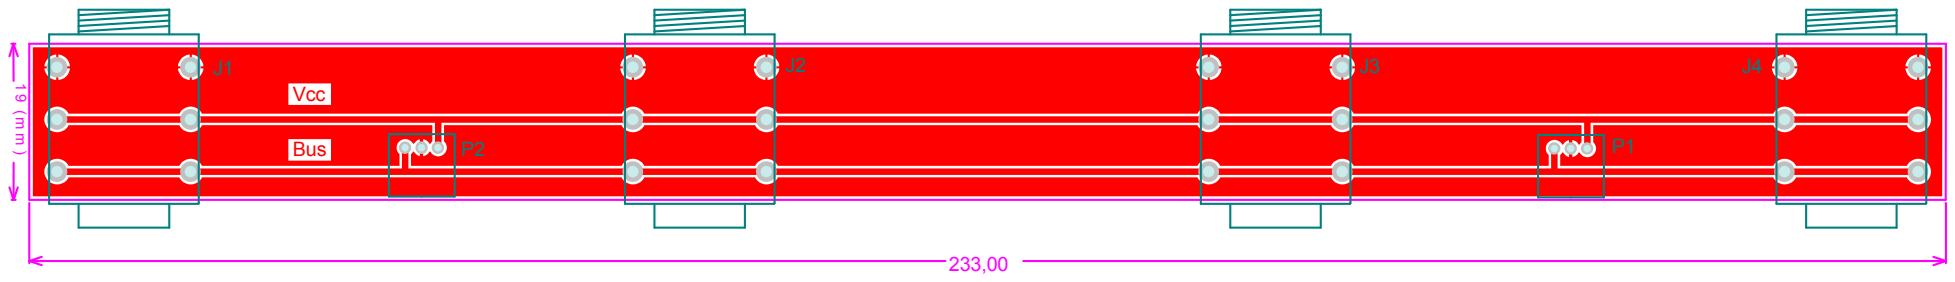
[picture p14: page 1]
Bus Vcc

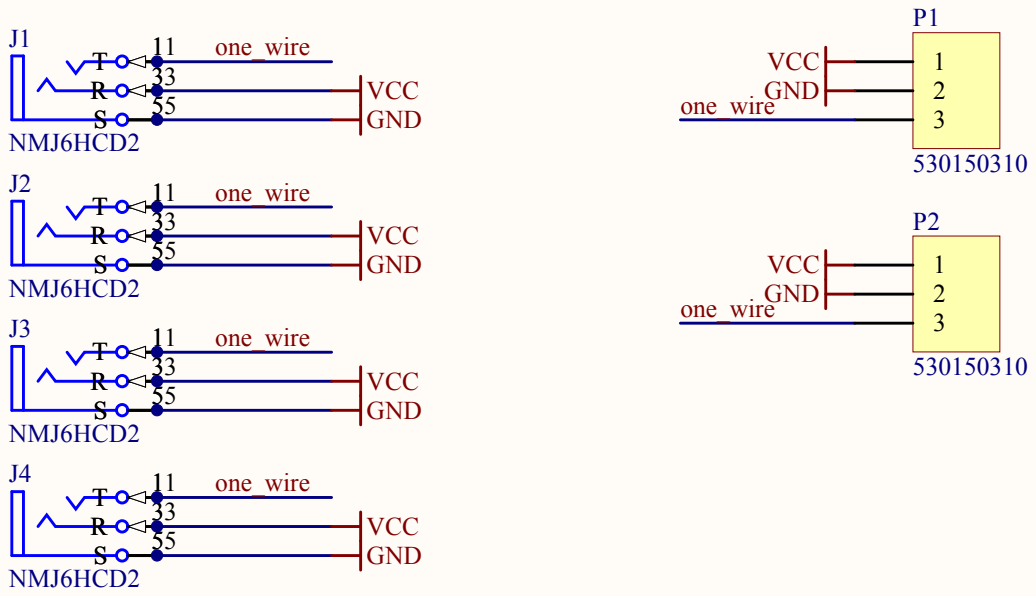
[picture p15: page 2]
Date:; Sheet of File:; W:\BACKUP_JD\..\jacks_matrix_v10.SchDoc Drawn By; NMJ6HCD2 T; GND one_wire

MAWZER JACKS MATRIX
