jerash/mawzer/schematics/POT_module_v10.pdf

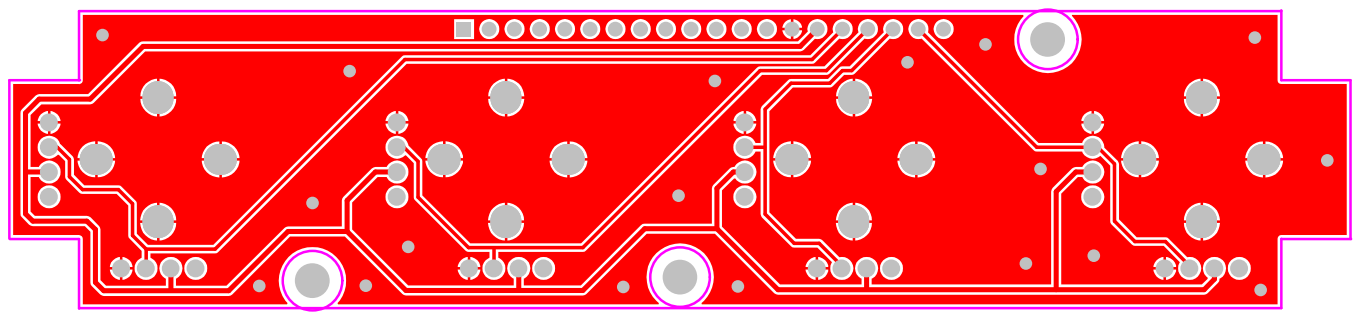
[picture p16: page 1]

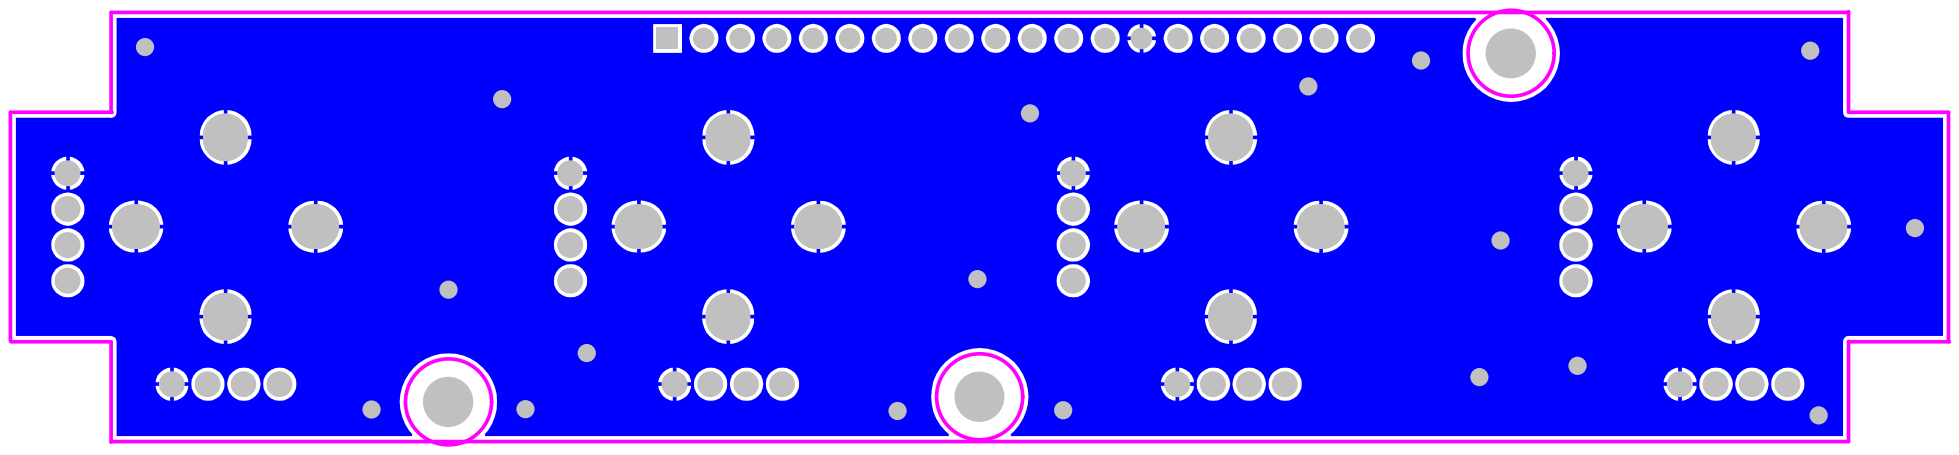
[picture p17: page 2]

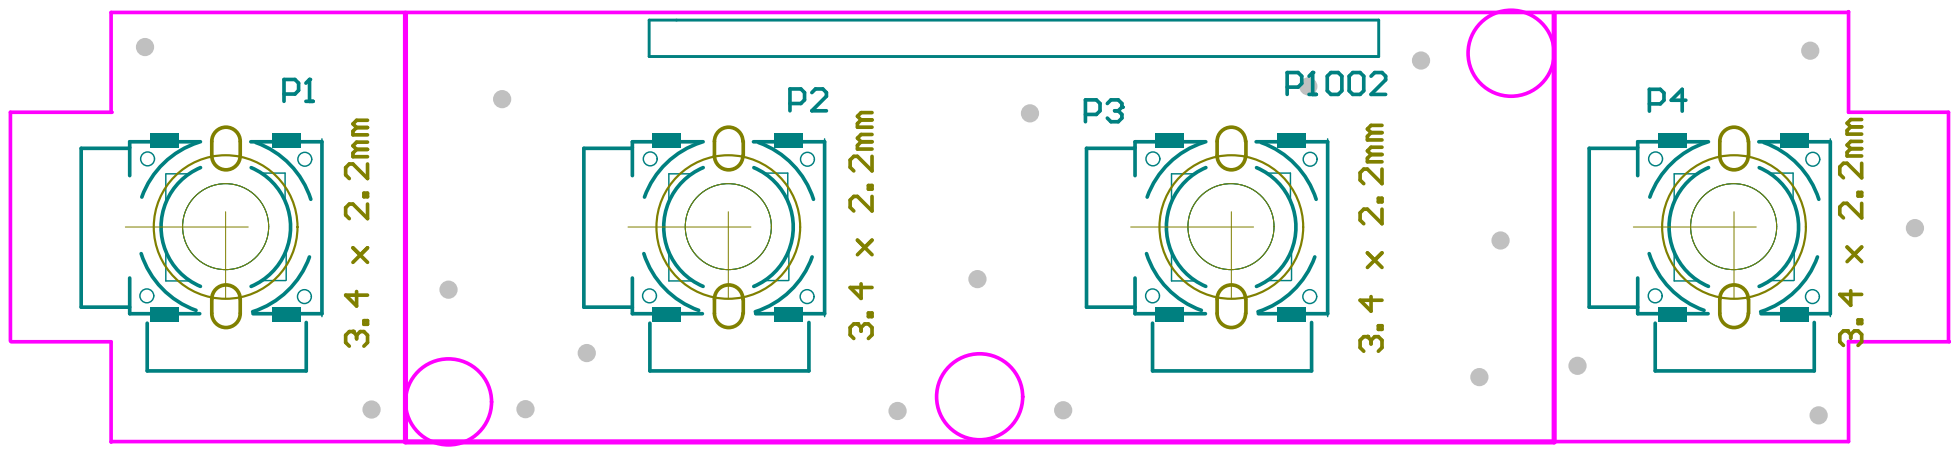
[picture p18: page 3]

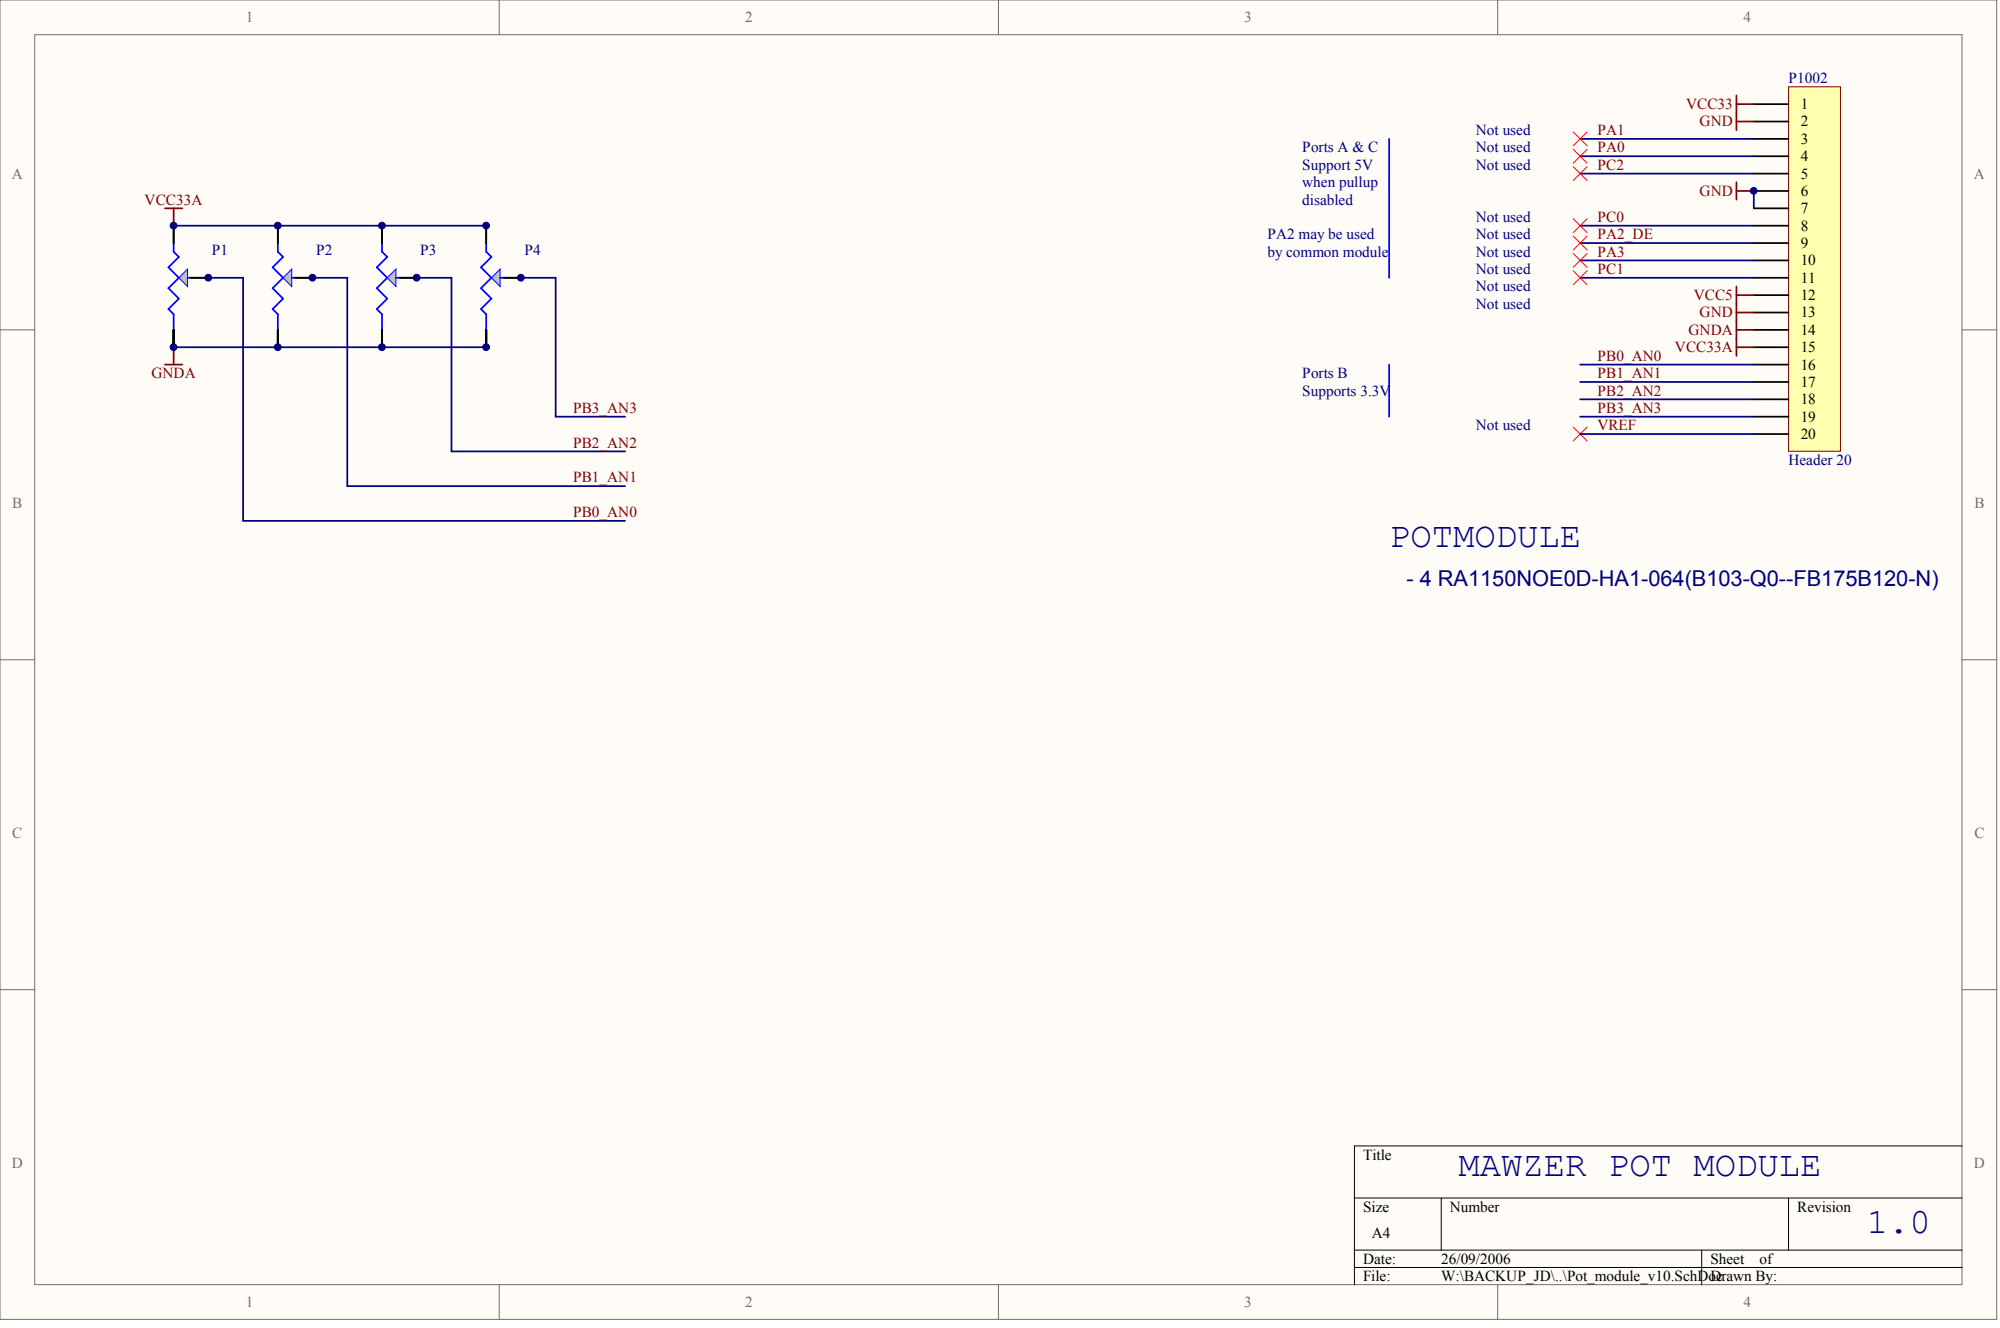
[picture p19: page 4]
Date:; Sheet of File:; W:\BACKUP_JD\..\Pot_module_v10.SchDocDrawn By; Not used; - 4 RA1150NOE0D-HA1-064(B103-Q0--FB175B120-N); Support 5V Ports A & C; when pullup; Supports 3.3V Ports B; PA2 may be used; by com; mon module; Header 20; VREF PB3_AN3 PB2_AN2 PC1; GND VCC33A; Not used Not used Not used Not used

MAWZER POT MODULE
