jerash/mawzer/schematics/Xfd_module_v10.pdf

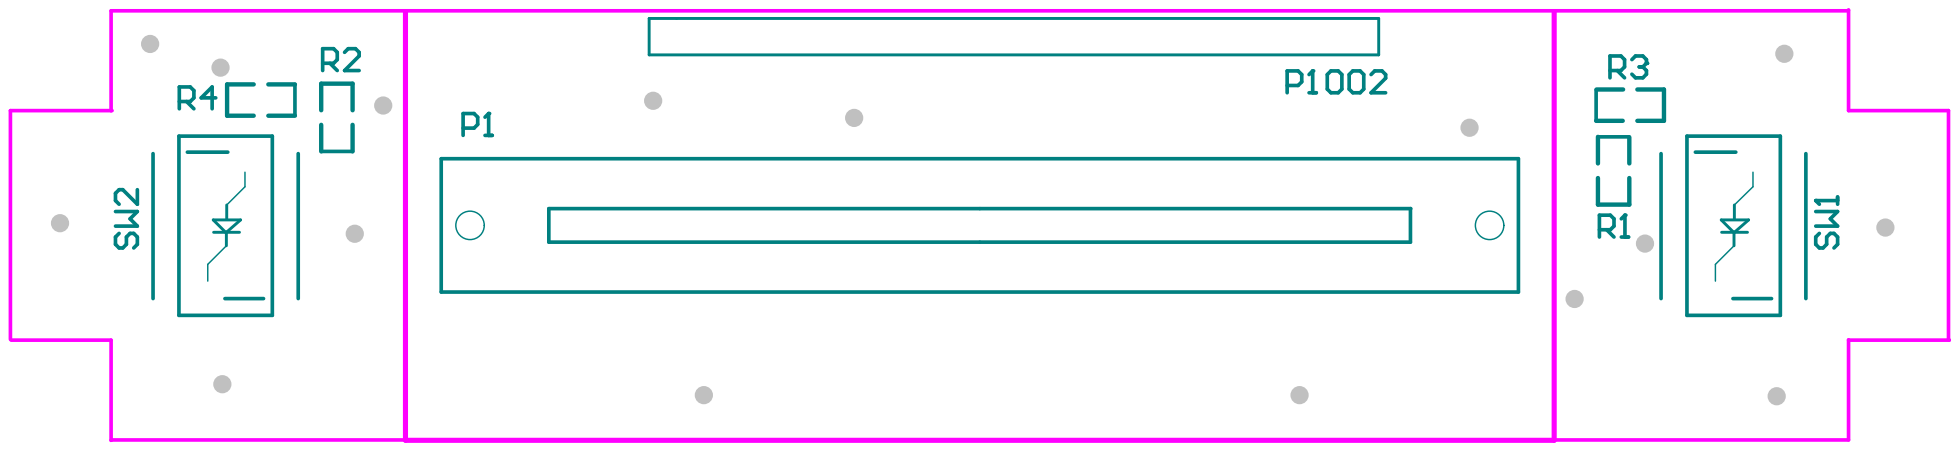
[picture p20: page 1]

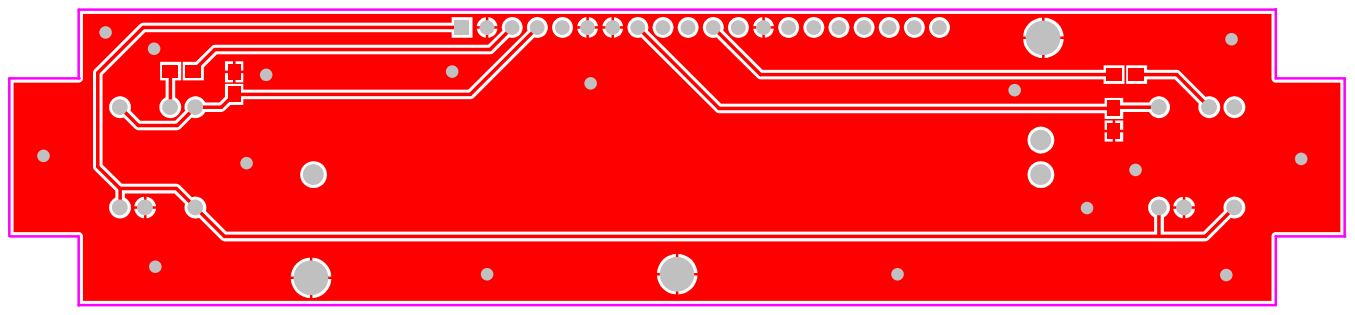
[picture p21: page 2]

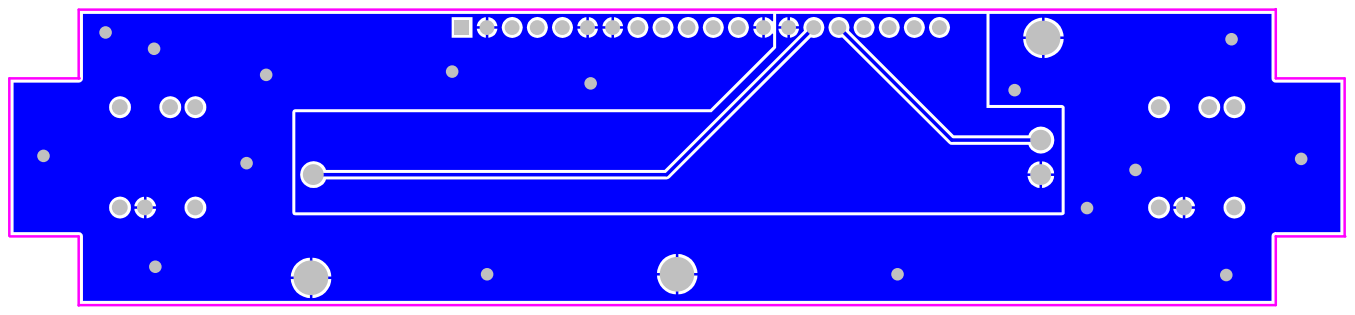
[picture p22: page 3]

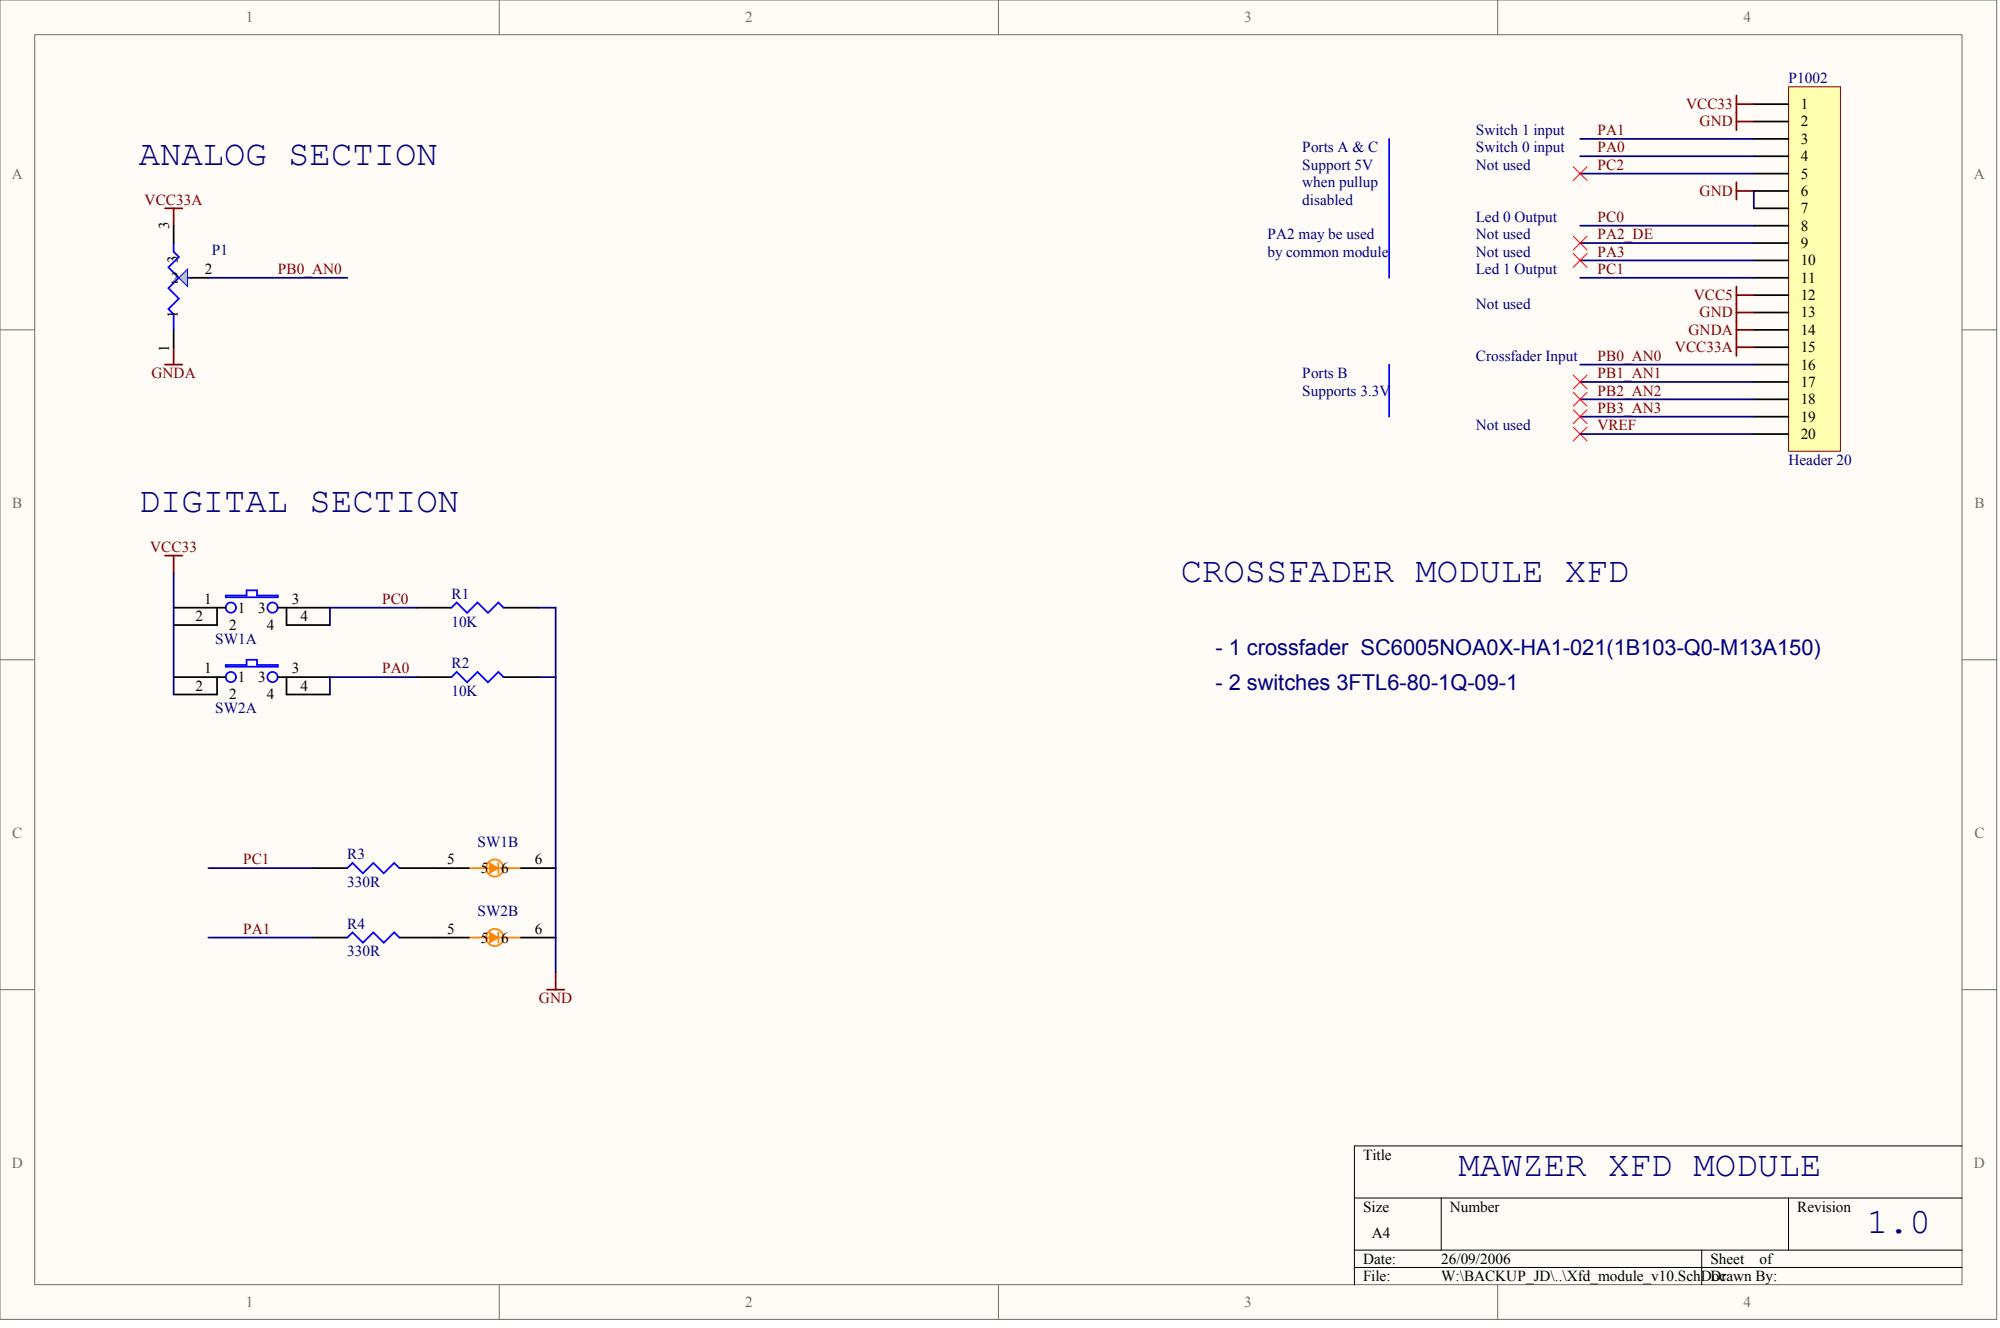
[picture p23: page 4]

Switch 1 input Led 0 Output Led 1 Output
Switch 0 input
Not used
