jerash/mawzer/schematics/ENC_MODULE_V10.pdf

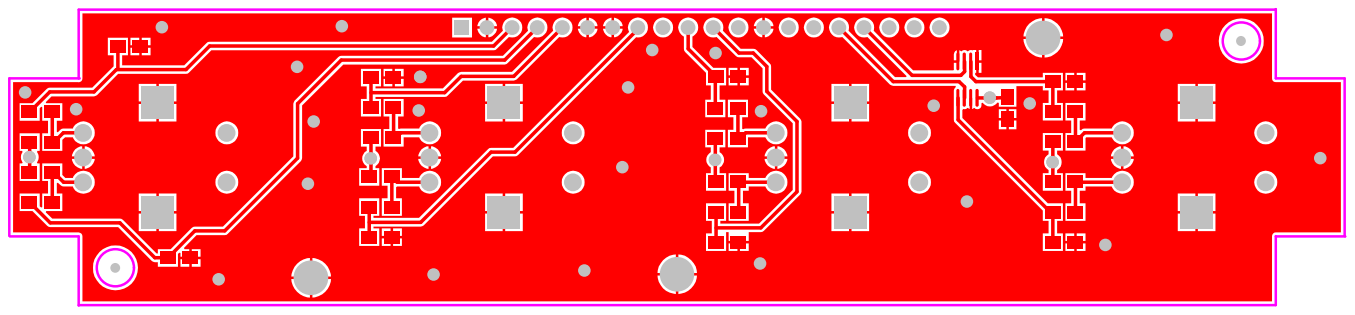
[picture p24: page 1]

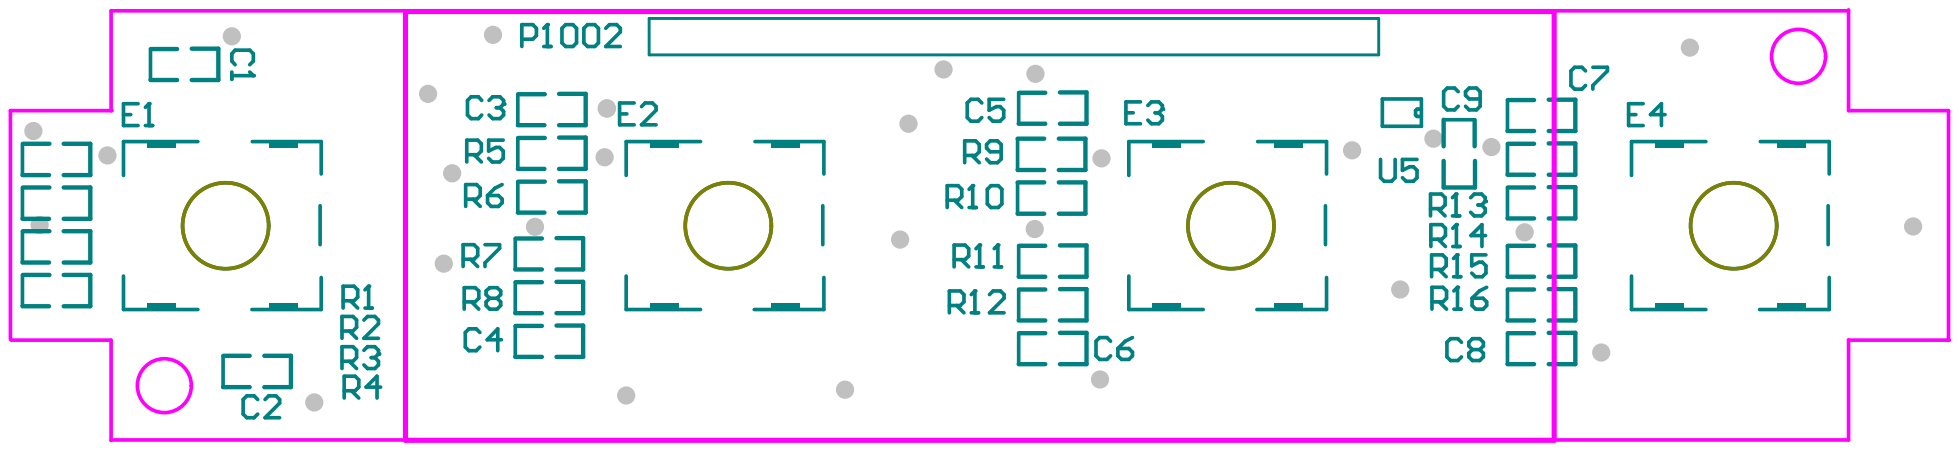
[picture p25: page 2]

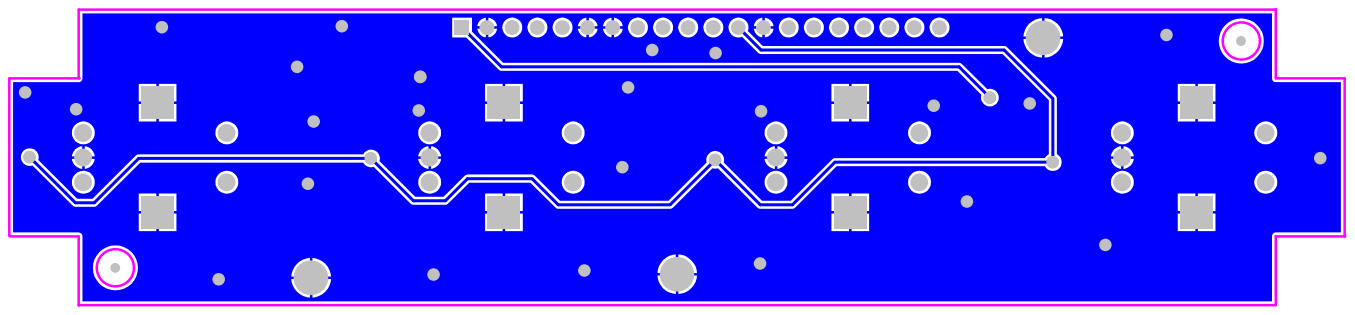
[picture p26: page 3]

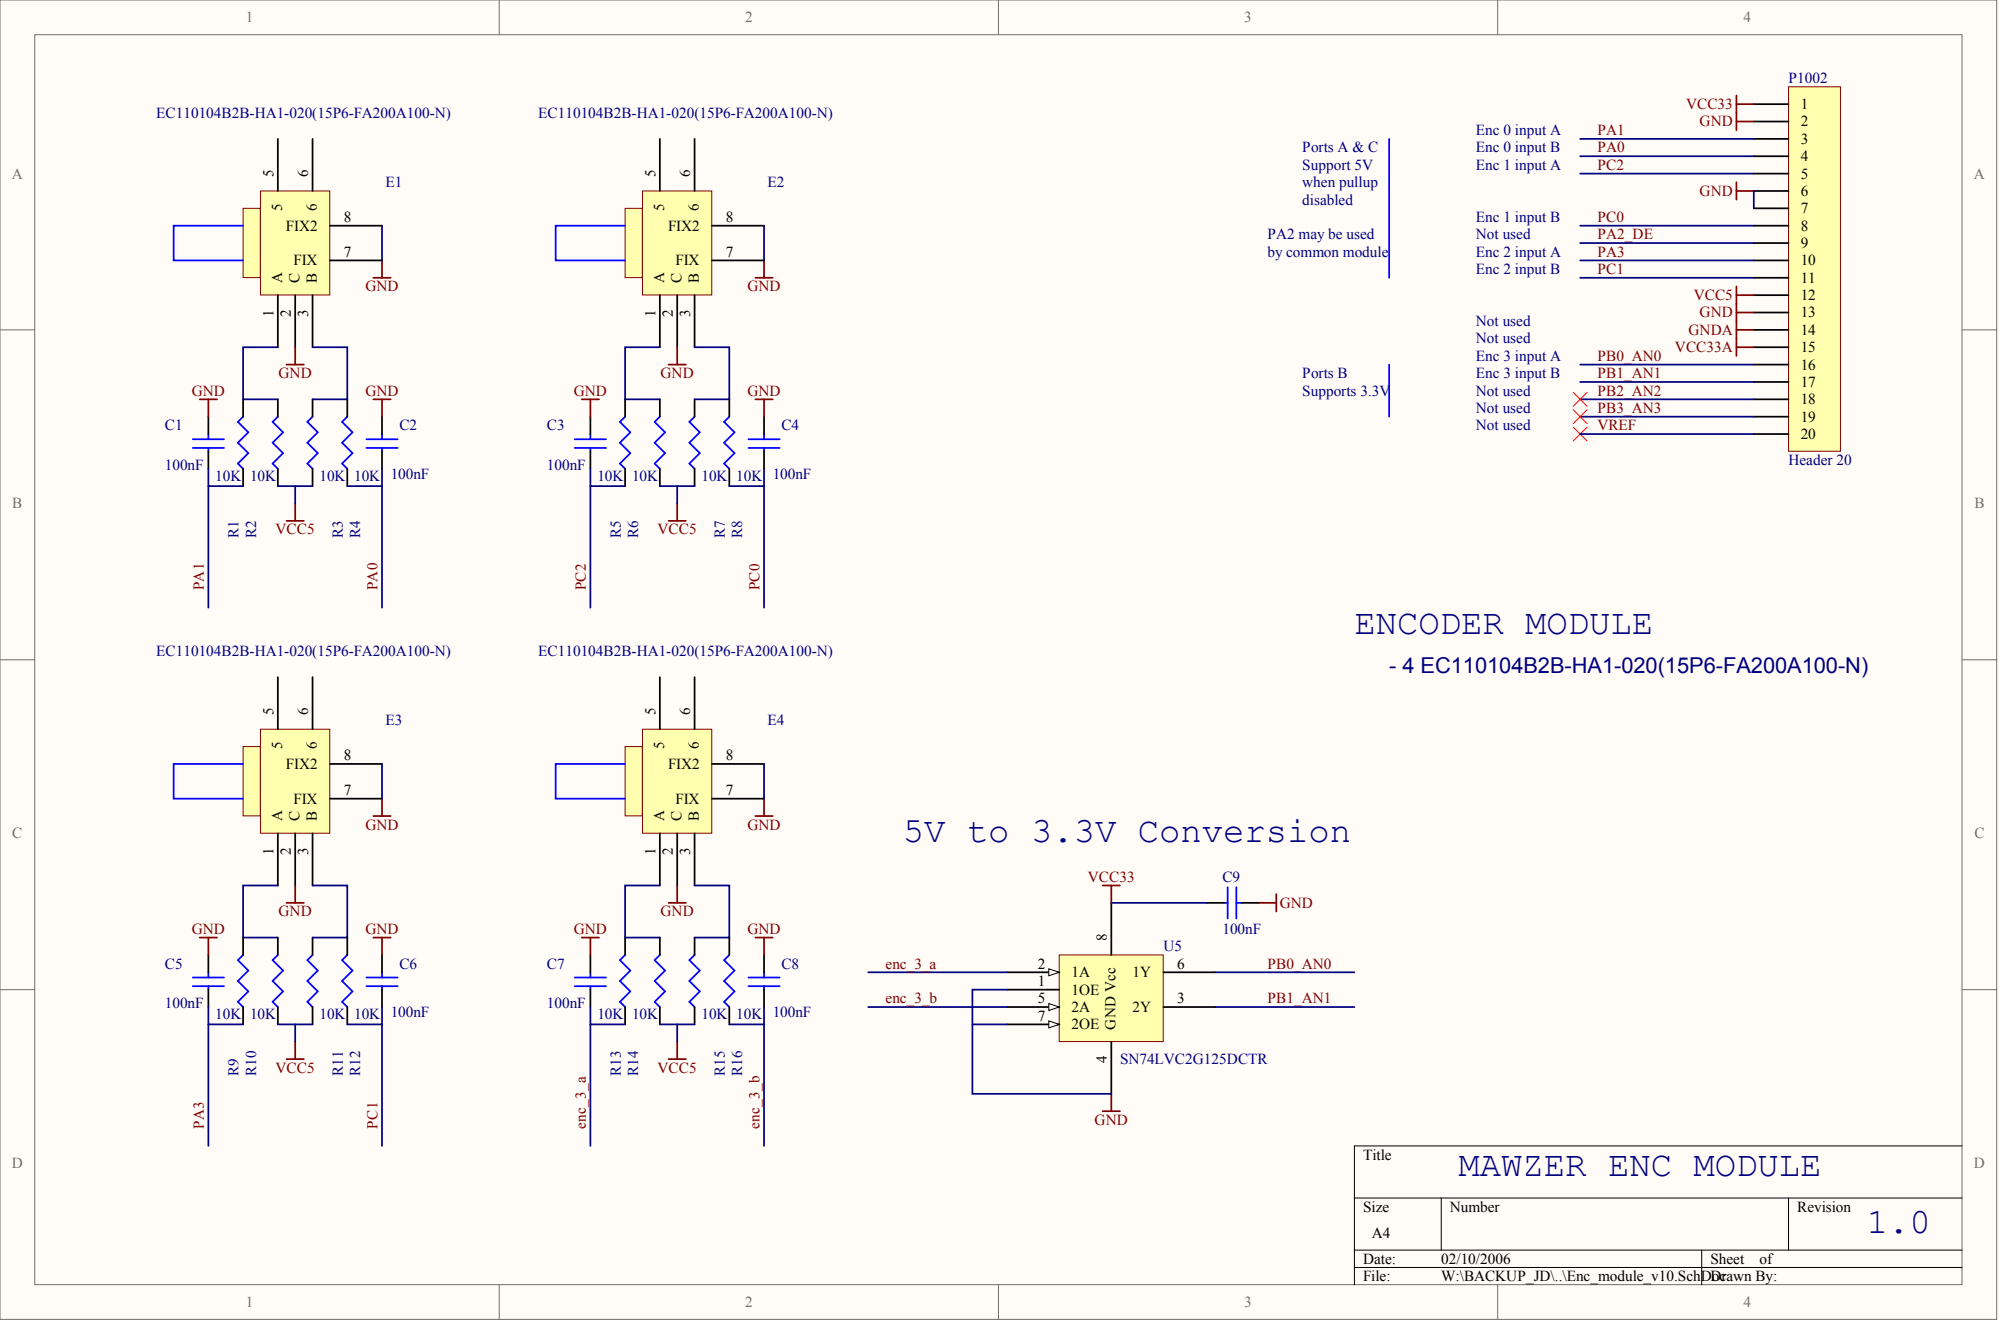
[picture p27: page 4]
