jerash/mawzer/src/Motherboard/Z8_Fw_v10/lcd_bmps.h

#ifndef LCD_BMPS
#define LCD_BMPS

///////////////////////////////////////////////////////////
// LCD BITMAPS
///////////////////////////////////////////////////////////

rom uchar bmp_home[] = {  128,				// total bmp width in pixel
			   				8,				// total bmp height in pages
0x00,0x00,0x00,0x00,0x00,0x00,0xE0,0xE0,0xFE,0xFE,0xFE,0xFE,0xFE,0xFE,0xFE,0xFE,
0xFE,0xFE,0xFE,0xFC,0x00,0x00,0xFC,0xFE,0xFE,0xFE,0xFE,0xFE,0xFE,0xFE,0xFE,0xFE,
0x06,0x02,0x02,0x02,0x02,0x02,0x02,0x02,0x02,0x02,0x02,0x02,0x7E,0xFE,0xFE,0xFE,
0xFE,0xFE,0xFE,0xE0,0x00,0x00,0x00,0xE0,0xFE,0xFE,0xFE,0xFE,0xFE,0xFE,0xFE,0xE0,
0x00,0x00,0x00,0xE0,0xFE,0xFE,0xFE,0xFE,0x82,0x82,0x82,0x82,0x82,0x02,0x02,0x02,
0x02,0x02,0x02,0x02,0x02,0xFE,0xFE,0xFE,0xFE,0xFE,0xFE,0xFE,0xFE,0xFE,0xFE,0xFE,
0xFE,0x02,0x02,0x02,0x02,0x02,0x02,0x02,0xC2,0xC2,0x82,0x02,0x02,0x02,0x06,0x06,
0x0E,0x3E,0xFE,0xFE,0xFE,0xFE,0xFE,0xE0,0xE0,0x00,0x00,0x00,0x00,0x00,0x00,0x00,
0x00,0x00,0x00,0x00,0x00,0x00,0x71,0x71,0xFF,0xFF,0xFF,0xFF,0xFF,0xFF,0xFF,0xFF,
0xFF,0xFF,0xFF,0xFF,0xF8,0xF8,0xFF,0xFF,0xFF,0xFF,0xFF,0xFF,0xFF,0xFF,0xFF,0x07,
0x00,0x00,0x00,0x00,0x00,0xE0,0xFC,0xE0,0x00,0x00,0x00,0x00,0x00,0x7F,0xFF,0xFF,
0xFF,0xFF,0xFF,0xFF,0xF0,0x00,0xF0,0xFF,0xFF,0xFF,0xFF,0xFF,0xFF,0xFF,0xFF,0xFF,
0xF0,0x00,0xF0,0xFF,0xFF,0xFF,0xFF,0xFF,0xFF,0xFF,0xFF,0x1F,0x01,0x00,0x00,0x00,
0x00,0x00,0x80,0xF0,0xFE,0xFF,0xFF,0xFF,0xFF,0xFF,0xFF,0xFF,0xFF,0xE0,0xE0,0xE0,
0xE0,0x00,0x00,0x00,0x00,0x00,0x00,0x00,0x3F,0x3F,0x1F,0x06,0x00,0x00,0x00,0x00,
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
0x1C,0x1E,0x7E,0x1C,0x1E,0x1E,0x1C,0x1E,0x1E,0x1C,0x7E,0x1E,0x1C
};

/*
rom uchar bmp_bus_off[] = {  13,			// total bmp width in pixel
			   			  	1,				// total bmp height in pages
0x1C,0x16,0x76,0x14,0x16,0x16,0x14,0x16,0x16,0x14,0x76,0x16,0x1C
};
*/

rom uchar bmp_no_cc_nb[] = {  31,			// total bmp width in pixel
			   			  	2,				// total bmp height in pages
0x00,0x80,0x80,0x80,0x80,0x80,0x80,0x80,0x80,0x80,0x80,0x00,0x80,0x80,0x80,0x80,
0x80,0x80,0x80,0x80,0x80,0x80,0x00,0x80,0x80,0x80,0x80,0x80,0x80,0x80,0x80,0x00,
0x00,0x00,0x00,0x00,0x00,0x00,0x00,0x00,0x00,0x00,0x00,0x00,0x00,0x00,0x00,0x00,
0x00,0x00,0x00,0x00,0x00,0x00,0x00,0x00,0x00,0x00,0x00,0x00,0x00,0x00
};

rom uchar bmp_menu_title[] = {  29,			// total bmp width in pixel
			   			  	    1,				// total bmp height in pages
0x00,0xFE,0xFE,0x82,0xF6,0xEE,0xF6,0x82,0xFE,0x82,0xAA,0xBA,0xFE,0x82,0xF6,0xEE,
0x82,0xFE,0x82,0xBE,0xBE,0x82,0xFE,0xFE,0x7E,0x3E,0x1E,0x0E,0x06
};

#endif
