jerash/mawzer/src/Modules/common_module/i2c.c

#include <eZ8.h>

#ifdef _MODULE_POT
	#include "pins_defs_POT.h"
#endif

#ifdef _MODULE_FAD
	#include "pins_defs_FAD.h"
#endif

#ifdef _MODULE_BUT
	#include "pins_defs_BUT.h"
#endif

#ifdef _MODULE_ENC
	#include "pins_defs_ENC.h"
#endif

#include "commondef.h"
#include "eeprom.h"
#include "i2c_low_level.h"
#include "i2c.h"


///////////////////////////////////////////////////////////////////////////////////////
// GLOBAL VARS
///////////////////////////////////////////////////////////////////////////////////////
uint  EE_Address;

//extern uchar Z8_STATUS_10;
extern uchar Z8_STATUS_4;

/*
///////////////////////////////////////////////////////////////////////////////////////
// Routine 	: ReadByteI2c()
// Inputs	: None
// Outputs	: None
// Process  : 
///////////////////////////////////////////////////////////////////////////////////////
uchar ReadByteI2c_24C16(void) 
{
	uchar data;

	// wait for EEProm ready 
	while(Z8_STATUS_4 & eeprom_locked_10ms_z4);

	MAC_I2cStart 									// I2C Start
	MAC_I2cSendNack									// Set the No Acknowledge bit
	data  = I2C_WRITE_COMMAND + I2C_SLAVE_ADR_EE;	// data = A0
	data += (uchar)((EE_Address>>7) & 0x0E);		// Add 3 MSBs of address (start at bit 1)
	MAC_I2cWriteByte(data)							// EEProm Address + Write command					
  	WaitI2cTransmitEmpty();							// wait for transmit buffer empty
//	MAC_I2cWriteByte((uchar)(EE_Address>>8))		// Load MSB EEProm Address					
//	WaitI2cAcknoledge();							// wait for ACK from EEProm (EE_WRITE_CTRL)
//	WaitI2cTransmitEmpty();							// wait for transmit buffer empty
	MAC_I2cWriteByte((uchar)(EE_Address & 0xFF))	// Load LSB EEProm Address
  	WaitI2cAcknoledge();							// wait for ACK from EEProm (Address high)
	WaitI2cTransmitEmpty();							// wait for transmit buffer empty
  
   	MAC_I2cStart									// I2C Start
  	WaitI2cAcknoledge();							// wait for ACK from EEProm (Address low)
	data  = I2C_READ_COMMAND + I2C_SLAVE_ADR_EE;	// data = A1
	data += (uchar)((EE_Address>>7) & 0x0E);		// Add 3 MSBs of address (start at bit 1)
	MAC_I2cWriteByte(data)							// EEProm Address + Write command					
	WaitI2cTransmitEmpty();							// wait for transmit buffer empty
 	WaitI2cAcknoledge();							// wait for ACK from EEProm (EE_READ_CTRL)
 	WaitI2cFullDataReceived();						// wait for receive data
	MAC_I2cReadByte(data)							// EEProm Read data
	I2cStop();                               		// I2C Stop
	return data;		

} 
*/
/*
///////////////////////////////////////////////////////////////////////////////////////
// Routine 	: WriteByteI2c()
// Inputs	: None
// Outputs	: None
// Process  : 
///////////////////////////////////////////////////////////////////////////////////////
void WriteByteI2c_24C16(uchar data)
{

	// DBG
	//return;

	// Initiate EEProm write sequence
	InitiateI2cWrite_24C16();

	MAC_I2cWriteByte(data)						// EEProm Write data
	WaitI2cAcknoledge();						// wait for ACK from EEProm (Address low)
	WaitI2cTransmitEmpty();						// wait for transmit buffer empty
	WaitI2cAcknoledge();						// wait for ACK from EEProm (data written)
	I2cStop();									// I2C Stop
	LockEEprom10Ms();

}
*/

///////////////////////////////////////////////////////////////////////////////////////
// Routine 	: WriteMultiByteI2c()
// Inputs	: None
// Outputs	: None
// Process  : 
///////////////////////////////////////////////////////////////////////////////////////
void WriteMultiByteI2c_24C16(far uchar *data_ptr, uchar data_lenght)
{
	uchar i;

	// DBG
	//return;

	// Initiate EEProm write sequence
	InitiateI2cWrite_24C16();

 //  	WaitI2cAcknoledge();					// wait for ACK from EEProm (Address low)

	for (i=0; i < data_lenght; i++)
	{		
	 	MAC_I2cWriteByte(data_ptr[i]);   	// EEProm Write data	
		WaitI2cTransmitEmpty();				// wait for transmit buffer empty
		WaitI2cAcknoledge();			    // wait for ACK from EEPROM	(data written)
    }
	I2cStop();								// I2C Stop
	LockEEprom10Ms();
}

///////////////////////////////////////////////////////////////////////////////////////
// Routine 	: InitiateI2cWrite()
// Inputs	: None
// Outputs	: None
// Process  : 
///////////////////////////////////////////////////////////////////////////////////////
void  InitiateI2cWrite_24C16(void)
{
	uchar data;

	// wait for EEProm ready 
	while(Z8_STATUS_4 & eeprom_locked_10ms_z4);

  	MAC_I2cStart									// I2C Start
//  MAC_I2cWriteByte((I2C_WRITE_COMMAND + I2C_SLAVE_ADR_EE))	// I2C EEProm Address; Write
	data  = I2C_WRITE_COMMAND + I2C_SLAVE_ADR_EE;	// data = A0
	data += (uchar)((EE_Address>>7) & 0x0E);		// Add 3 MSBs of address (start at bit 1)
	MAC_I2cWriteByte(data)							// EEProm Address + Write command		
	WaitI2cAcknoledge();							// wait for ACK from EEProm (EE_WRITE_CTRL)		
  	WaitI2cTransmitEmpty();							// wait for transmit buffer empty
//  MAC_I2cWriteByte((uchar)(EE_Address>>8))		// Load MSB EEProm Address					
//	WaitI2cAcknoledge();							// wait for ACK from EEProm (EE_WRITE_CTRL)
//  WaitI2cTransmitEmpty();							// wait for transmit buffer empty
  	MAC_I2cWriteByte((uchar)(EE_Address & 0xFF))	// Load LSB EEProm Address
	WaitI2cAcknoledge();							// wait for ACK from EEProm (Address High)
  	WaitI2cTransmitEmpty();							// wait for transmit buffer empty
}

///////////////////////////////////////////////////////////////////////////////////////
// Routine 	: ReadMultiByteI2c()
// Inputs	: None
// Outputs	: None
// Process  : 
///////////////////////////////////////////////////////////////////////////////////////
//void ReadMultiByteEEprom(uchar *data_ptr, uchar data_lenght)
void ReadMultiByteI2c_24C16(far uchar *data_ptr, uchar data_lenght)
{

	uchar index, data_read, data;
	uchar last_byte = data_lenght-1;

	//DBG 
	//return;

	// Initiate EEProm write sequence
	InitiateI2cWrite_24C16();

//   	WaitI2cAcknoledge();						// wait for ACK from EEProm (Address low)
   
	MAC_I2cStart	
// 	MAC_I2cWriteByte((I2C_READ_COMMAND + I2C_SLAVE_ADR_EE))	// EEProm Address; Read	
	data  = I2C_READ_COMMAND + I2C_SLAVE_ADR_EE;	// data = A1
	data += (uchar)((EE_Address>>7) & 0x0E);		// Add 3 MSBs of address (start at bit 1)
	MAC_I2cWriteByte(data)							// EEProm Address + Write command					

	WaitI2cTransmitEmpty();						// wait for transmit buffer empty   
	WaitI2cAcknoledge();						// wait for ACK from EEProm (EE_READ_CTRL)
		
	for(index=0;index < data_lenght ;index++)
	{
		if(index == last_byte)
		{
			MAC_I2cSendNack						// Send No ack on last byte to read
     	}
		WaitI2cFullDataReceived();
		MAC_I2cReadByte(data_read)				// EEProm Read data		
		data_ptr[index] = (far uchar)(data_read);			// assign data read to pointer
		//EE_far_buffer[index] = data_read;
    }
    I2cStop(); 
}
