jerash/mawzer/src/Modules/common_module/main.h

#ifndef MAIN
#define MAIN

///////////////////////////////////////////////////////////
// GLOBAL definitions
///////////////////////////////////////////////////////////

///////////////////////////////////////////////////////////
// Function Prototypes
///////////////////////////////////////////////////////////
void main (void);
#endif
