jerash/mawzer/src/Motherboard/Z8_Fw_v10/lcd_fonts.h

#ifndef LCD_FONTS
#define LCD_FONTS

///////////////////////////////////////////////////////////
// LCD FONTS
///////////////////////////////////////////////////////////
enum { FONT_5X7 };	// V1.5 List all available fonts

// Font mapping is defined as follow :
// Font is 8 pix fixed width, 16 pix fixed height (2 bytes)
// organization is : row0, row1, row0, row1 ...
// for caracters spacing, the display function must add 0,0 at each
// start and end of fonct definition 

rom uchar font_5x8[] = {   	5,							// caracter byte lenght = offset !!
						    0,							// Y Pages used by 1 character	expressed in 2^n (1 means 2)
						    1,							// leading pixels to add before
						  	' ',							// font first caracter coded
							0x00, 0x00, 0x00, 0x00, 0x00,	 // 	space
							0x00, 0x00, 0xBE, 0x00, 0x00,	 // 	exclamation
							0x0E, 0x06, 0x00, 0x0E, 0x06,	 // 	double guillement
							0x24, 0x7E, 0x24, 0x7E, 0x24,	 // 	diese
							0x4C, 0x92, 0xFE, 0x92, 0x64,	 // 	dollar
							0x4C, 0x2C, 0x10, 0x68, 0x64,	 // 	pourcentage
							0x70, 0x9C, 0xB2, 0x4A, 0xA4,	 // 	et
							0x00, 0x06, 0x0E, 0x00, 0x00,	 // 	guillemet
							0x00, 0x38, 0x44, 0x82, 0x00,	 // 	parenthese ouvre
							0x00, 0x82, 0x44, 0x38, 0x00,	 // 	parenthese ferme
							0x54, 0x38, 0x7C, 0x38, 0x54,	 // 	etoile
							0x10, 0x10, 0x7C, 0x10, 0x10,	 // 	plus
							0x00, 0x80, 0x60, 0x00, 0x00,	 // 	virgule
							0x10, 0x10, 0x10, 0x10, 0x10,	 // 	moins
							0x00, 0xC0, 0xC0, 0x00, 0x00,	 // 	point
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
0xF0, 0x3C, 0xF8, 0x7F, 0x0C, 0xC3, 0x0C, 0xC3, 0x0C, 0xC3, 0x0C, 0xC3, 0x0C, 0xC3, 0x0C, 0xC3, 0xF8, 0x7F, 0xF0, 0x3C, //8 
0xF0, 0x30, 0xF8, 0x71, 0x0C, 0xC3, 0x0C, 0xC3, 0x0C, 0xC3, 0x0C, 0xC3, 0x0C, 0xC3, 0x0C, 0xC3, 0xF8, 0x7F, 0xF0, 0x3F //9
};
#endif
