jerash/mawzer/src/Modules/module_BUT/itrs_BUT.h

#ifndef ITRS_BUT
#define ITRS_BUT

///////////////////////////////////////////////////////////
// Function Prototypes
///////////////////////////////////////////////////////////
void InitModuleItrs(void);

#endif
