jerash/mawzer/src/Modules/module_ENC/itrs_ENC.h

#ifndef ITRS_ENC
#define ITRS_ENC

///////////////////////////////////////////////////////////
// Function Prototypes
///////////////////////////////////////////////////////////
void InitModuleItrs(void);

#endif
