jerash/mawzer/src/Modules/module_FAD/itrs_FAD.h

#ifndef ITRS_FAD
#define ITRS_FAD

///////////////////////////////////////////////////////////
// Function Prototypes
///////////////////////////////////////////////////////////
//void isr_adc(void);
void InitModuleItrs(void);

#endif
