jerash/mawzer/src/Modules/module_POT/itrs_POT.h

#ifndef ITRS_POT
#define ITRS_POT

///////////////////////////////////////////////////////////
// Function Prototypes
///////////////////////////////////////////////////////////
//void isr_adc(void);
void InitModuleItrs(void);

#endif
