jerash/mawzer/src/Motherboard/Z8_Fw_v10/digital.h

#ifndef DIGITAL
#define DIGITAL

///////////////////////////////////////////////////////////
// Function Prototypes
///////////////////////////////////////////////////////////
void CheckTransportButtons(void);
void CheckButtons(void);

#endif
