jerash/mawzer/src/Motherboard/Z8_Fw_v10/i2c.h

#ifndef IIC
#define IIC

///////////////////////////////////////////////////////////
// Local Definition
///////////////////////////////////////////////////////////



///////////////////////////////////////////////////////////
// Function Prototypes
///////////////////////////////////////////////////////////

uchar ReadByteI2c(void);
uchar WriteByteI2c(uchar data);
void  InitiateI2cWrite(void);
void  WriteMultiByteI2c(far uchar *data_ptr, uchar data_lenght);
void  ReadMultiByteI2c(far uchar *data_ptr, uchar data_lenght);

#endif
