jerash/mawzer/src/Motherboard/Z8_Fw_v10/itrs.h

#ifndef ITRS
#define ITRS

///////////////////////////////////////////////////////////
// Function Prototypes
///////////////////////////////////////////////////////////
void InitItrs(void);
void UpdateFunctionsToIncrease(void);
void UpdateFunctionsToDecrease(void);
void Encoder2Increase(void);
void Encoder2Decrease(void);
#endif
