jerash/mawzer/src/Motherboard/Z8_Fw_v10/lcd_texts.h

#ifndef LCD_TEXTS
#define LCD_TEXTS

///////////////////////////////////////////////////////////
// LCD TEXTS
///////////////////////////////////////////////////////////

rom uchar midi_in_txt[]				= "MIDI IN";
rom uchar serial_in_txt[]			= "SERIAL IN";
rom uchar usb_in_txt[]				= "USB  IN";
rom uchar realtime_txt[]			= "REALTIME";
rom uchar overflow_txt[]			= "OVERFLOW !";
rom uchar modules_txt[]				= "MODULES";
rom uchar found_txt[]				= "FOUND";
rom uchar reset_txt[]				= "RESETTING - WAIT";
//rom uchar done_txt[]				= "DONE";
rom uchar default_grp_name_txt[]	= "preset ";
rom uchar searching_txt[]			= "searching";
rom uchar updating_txt[]			= "updating";
rom uchar modules_lc_txt[]			= "modules";
// rom uchar menus_txt[]				= "MENUS";
rom uchar communication_txt[]		= "COMMUNICATION";
rom uchar error_txt[]				= "ERROR";
rom uchar sysex_txt[]				= "SYSEX";
rom uchar autoassign_txt[]			= "AUTO-ASSIGN";
rom uchar corrupted_struct_txt[]	= "Undefined Ctrl";
rom uchar smpte_txt[]				= "SMPTE";
rom uchar smpte_2points_txt[]		= "  :  :  :  ";
rom uchar control_txt[]				= "CONTROL";
rom uchar to_assign_txt[]			= "TO ASSIGN ?";
rom uchar module_txt[]				= " MODULE";
#endif
