jerash/mawzer/src/Motherboard/Z8_Fw_v10/serial.h

#ifndef SERIAL
#define SERIAL

///////////////////////////////////////////////////////////
// Local defines
///////////////////////////////////////////////////////////
#define BAUD1 	 	125000 // 78125 // 62500      				// 62,5K baud for ONEWIRE

#define BRG1 	Z8_FREQ/((unsigned long)BAUD_Z8_EZ*16)
#define BRG0 	Z8_FREQ/((unsigned long)BAUD1*16)

#define TDRE	4U

#define TX_BUFF_LENGTH			128U // V1.5 128U
#define SERIAL_IN_BUFF_LENGHT	256  // V1.5 128U

#define UPLOAD_Z8_FRAME_LENGHT		0x06U 	// FF SS LL AA/NN 00/GG FE
#define LCD_MESS_Z8_FRAME_LENGHT	0x05U 	// FF SS LL AA FE
#define FRAME_HEADER_LENGHT			0x07U	// FF SS LL AA/NN 00/GG ... CS FE

#define INVALID_REQUEST				0xFFU
#define DEFAULT_INTERNAL_TEMPO		100 // 30 will be added : 130 

// TX_STATUS bits definitions
#define tx0_busy_txstat			(1<<6U)
#define tx0_full_txstat			(1<<5U)
#define tx1_busy_txstat			(1<<4U)
#define tx1_full_txstat			(1<<3U) 

// Programmation Frame mapping (valable only for FRAME_TYPE different than pure midi)
enum { FRAME_SOF_POS, FRAME_TYPE_POS, FRAME_DATA_LENGHT_POS, FRAME_ADDR_INDEX_POS, FRAME_GROUP_POS, FRAME_DATA_START };

enum {MIDI_STRUCT_VALID, MIDI_STRUCT_NOT_VALID};
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
