jerash/mawzer/(commit log)

2024-07-14 add schematics
2024-07-14 add hierarchical BOM
    [BOM Mawzer V0-2I.XLS]
2025-03-11 add sourcecode and firmware
    [STARTUP.OBJ, USBJmpTb.OBJ, bootloader.OBJ, dscr.OBJ, dscr_bs3x.OBJ, dscr_mawzer.OBJ, fw.OBJ, hardware.OBJ]
